Quezka/moneysort/docs/GRIPPER.md

# Gripper research: suction cup for coins

> The build that follows from this research is in [`PUMP.md`](PUMP.md).

Notes from a web search (2026-10-14) on how to pick up coins. Nothing here is
built yet; this records the options and the decision so far.

## Decision (so far)

A **small DC diaphragm vacuum pump + a solenoid release valve**, both switched by
logic-level MOSFETs from two Pi GPIOs. Not a venturi ejector: it needs
compressed air (a compressor and regulator), which is out of scale for a desk arm.

## How much suction a coin needs (our estimate, not from a source)

A coin weighs 2-9 g. A 5 mm cup at -30 kPa holds about 60 g (F = P x A), so the
margin is 5x or more. Coins are flat and seal well: the cup (small, soft lip or
bellows) matters more than pump flow.

Reference: the uArm Swift's built-in pump uses 5-10 mm cups, reaches 33 kPa and
lifts 1 kg ([datasheet](https://www.mouser.com/datasheet/2/813/uArm-Swift-Specifications-en-1223866.pdf)).

## Venturi ejectors (rejected)

- [Anver JV miniature venturi](https://anver.com/venturi%20vacuum%20pumps.htm): 16 g, no moving parts, up to 26" Hg,
  millisecond attach and release. Needs compressed air; air use is the main cost.
- [Riegler SCP 101-M mini-pump](https://riegler.de/de/en/mini-compact-ejector-mini-pump-nozzle-size-1-mm-nc-108397-1.html):
  built-in vacuum switch, 85% evacuation, about 639 EUR ex VAT. Out of proportion.

## Pumps found

- [SparkFun 12 V diaphragm pump (ROB-10398)](https://sparkfun.com/products/10398): 1000 h rated life. Works, but bigger than needed.
- [Evelta 12 V brushless piston pump](https://evelta.com/12v-mini-brushless-piston-vacuum-pump-for-suction-systems-max-flow-26l-min/)
  (18 or 26 L/min): made for pick-and-place, oversized for coins.
- Better: a micro diaphragm pump of the kind built into small arms. No specific
  buyable model found yet (open item).

## Release valve is required

Switching the pump off does not release the grip
([SparkFun community thread](https://community.sparkfun.com/t/an-open-source-robot-arm-project/27897/13)).
Put a solenoid valve on the line that vents the cup to atmosphere. So two outputs:
pump and valve. A normally-open valve vents on power loss (a coin drops rather
than stays held on a dead arm).

## Driving it from the Pi

- GPIO is 3.3 V only: switch the pump and valve through **logic-level MOSFETs**
  (gate threshold below ~2.5 V) with a flyback diode across each load, GND common
  with the Pi. Avoid IRF520 modules: they need ~10 V on the gate.
- Choosing a **24 V** pump and valve lets them share the stepper PSU (no converter).
  A 12 V part needs a 24 -> 12 V buck.

The cycle that will call the pump (`pick()` / `release()` hooks, drop spot, calibration) is in
[`PICKING.md`](PICKING.md).

## Open items

- Pick a concrete pump + valve + cup (5-8 mm, soft lip or bellows) available in Italy.
- Choose two free GPIO pins (check `PINOUT.md`).
- Software: pins in `config.py`, a `Gripper` in `hardware/`, `POST /grip` with a
  dead-man like `/jog` (never leave the pump running on a lost connection).

## Where to buy (searched 2026-10-14; check price, stock and real specs before ordering)

Cups (Italy, RS Components): [SMC ZP06BS](https://it.rs-online.com/web/p/ventose-pneumatiche/2273884) 6 mm bellows
(6.80 EUR + VAT), [SMC ZP2-05ZJS](https://it.rs-online.com/web/p/ventose-pneumatiche/0391989) 5 mm bellows (7.02 EUR + VAT).
Those are the pad only: check the mounting/fitting (nipple or holder) before buying. Cheap alternative: uxcell 6 mm
with M5 joint, 4 pcs ([Amazon listing](https://www.amazon.com/clp/B07MG5PK77)).

Pump + valve kits (6 V class, the "Arduino robot arm" kind):
- AliExpress: [pump + valve + PWM switch + cup](https://www.aliexpress.com/item/4000186490327.html),
  [same kit, other seller](https://aliexpress.com/item/1005003181120488.html),
  [cup + pump for Arduino arms](https://www.aliexpress.com/item/1005002310813942.html). Listing text is marketing:
  confirm the pump voltage (5-6 V) and vacuum (kPa) with the seller.
- Little Bird (AU) and ThinkRobotics sell the same kind of kit (pump 4.5-6.6 V, 3-way valve 6 V).
- DFRobot 6 V 3-way air valve ([RobotShop EU](https://eu.robotshop.com/products/dfrobot-6v-2-position-3-way-air-valve-arduino), ~100 mA, 40 kPa max).
- Alibaba is wholesale: [6 V mini vacuum pumps](https://pumpdyx.en.alibaba.com/productgrouplist-214713373/Mini_Vacuum_Pump.html),
  [vacuum release valves](https://www.alibaba.com/showroom/micro-vacuum-valve.html); expect minimum orders and no datasheets.
- Amazon.it: nothing suitable found by search (only 220 V HVAC pumps). Search on the site for "pompa vuoto 6V DC mini".

What to look for: pump 5-6 V DC, vacuum at least -40 kPa, a 3-way valve (so the cup vents on release), 4-5 mm nozzle.
A 6 V part needs its own supply (24 V -> 6 V buck), not the Pi's 5 V rail.

## Pump candidate (screenshot kept)

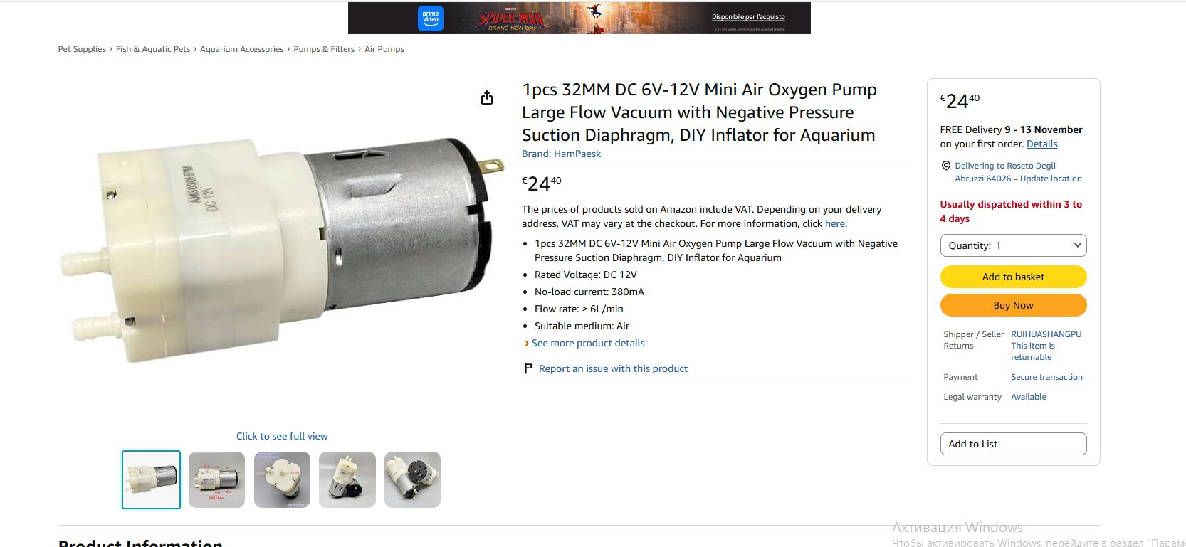
[picture p1: docs/img/pump-candidate-amazon-hampaesk.png]
Amazon.it listing, HamPaesk 32 mm pump


Amazon.it, 2026-10-14: "32MM DC 6V-12V Mini Air Oxygen Pump, Large Flow Vacuum with Negative Pressure Suction
Diaphragm" (brand HamPaesk, ASIN B0FNN55NGD), 24.40 EUR incl. VAT, returnable. Listed: rated 12 V (title says 6-12 V),
no-load 380 mA, flow > 6 L/min, medium air, two barbed ports. **Max vacuum is not stated** (the number that matters
for coins: want at least -50 kPa); price is high for this pump class. Ask the seller / read "more product details"
before buying; a 12 V part needs a 24 -> 12 V buck and a 12 V 3-way valve.
