Quezka/moneysort/docs/CAMERA_MOUNT.md

# Camera mount: RealSense D435 on the front of the arm

3D model (parametric, printable) of a bracket that carries the D435 at the **front of the arm**, plus a
holder for the suction nozzle. Source: [`cad/camera_mount.py`](../cad/camera_mount.py); print file:
[`cad/camera_mount.stl`](../cad/camera_mount.stl); assembly with a plate stub and a camera mock-up:
[`cad/camera_mount_assembly.stl`](../cad/camera_mount_assembly.stl) (for a viewer, not for printing).

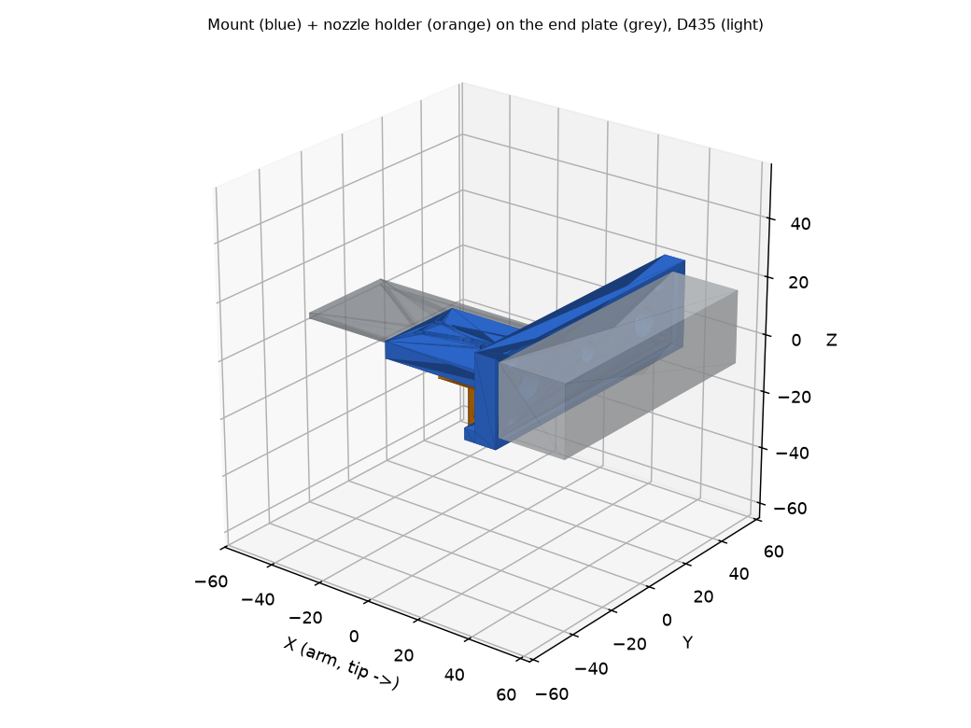
[picture p2: docs/img/camera-mount-iso.png]
Mount on the end plate


## What the photos show

- The forearm ends in a **horizontal flat plate** (the levelling wrist keeps it level at every pose), carried
  by a triangular gusset and two vertical side plates, with brass hex standoffs behind it.
- The plate has a **rectangular window ~40 x 20 mm** with **4 small holes** (two at each end of the window):
  the pattern of a standard servo bracket (MG996R: 49.5 x 10 mm). The window is on the arm's axis, with the long
  side along the arm. The plate's front edge is ~32 mm in front of the window centre, and about 36 mm wide.
- The D435 is 90 x 25 x 25 mm with a **1/4-20 tripod thread in the middle of its bottom face** and a USB-C
  connector on one short end.
- The brass standoffs sit ~10 mm above the plate: there is room for bolt heads on top of the plate.

These dimensions come from the photos (scale taken from the 20 x 40 mm window), so they are good to a
millimetre or two, not better: see **Check before printing**.

## The design

```
          side view (arm to the left, tip to the right)

  ======== plate (2) =========[ window ]===========+
          | printed block (6) under the plate      |#| wall (8) in front of the plate edge
          +----------+---------+------------------+#|----[ D435 ]----   <- lens face looks DOWN
                     | boss (nozzle holder)         |
                     | tube / cup stem
```

- **Block** (34 x 61 x 6 mm) under the plate, bolted through the 4 plate holes (M3 bolts from the top, nuts in
  hexagonal pockets on the underside). The pull of the camera's weight is resisted by the holes 49.5 mm apart.
- **Wall** (98 x 8 mm) right in front of the plate edge. The camera's **bottom face** is bolted to it with the
  1/4-20 screw, turned so that its **lenses look straight down** (the plate is always level, so the camera
  always looks straight down). A shallow pocket (90.6 x 25.6 x 2 mm) stops it rotating. The camera ends up with
  its long axis across the arm and the lens face 4 mm below the plate.
- **Nozzle holder** (a separate small part, `cad/nozzle_holder.stl`, printed flange-down): a 14 mm tube with a 6.4 mm
  bore hanging under the block, exactly under the plate window (the window is the opening for the tube going up to the
  pump), with an M3 set screw to clamp the stem. Two M3 bolts go in from the top through the window and the block, nuts in
  the flange. Adapt the bore when the suction cup is chosen ([`GRIPPER.md`](GRIPPER.md)).
- Four cable-tie slots (both wings, so the USB-C end can face either side) and lightening holes in the wings.
- Printed parts: mount 30 cm^3 (about **21 g** with 40% infill, PETG) + holder 4 g. Total added load about 110 g (camera 72 g, bolts).

### Why the camera is *in front of* the nozzle

- The **nozzle sits ~51 mm behind the camera centre**, 47 mm lower than the lens face. Seen from the lens the
  nozzle is 47 deg off the vertical (the depth stream sees +-29 deg along the arm), so it is **never in the
  picture** and does not occlude coins. The picture still contains the spot under the nozzle (about 106 px
  behind the image centre at 30 cm height): `--calibra` learns that pixel.
- The camera stays **above the pile**: while the nozzle touches a coin the lens is ~50 mm above the table.
- The window region of the plate is used by the nozzle, so there is nowhere else to put the camera (behind the
  window are the standoffs and side plates).
- Rejected: camera on top of the arm tilted forward (the image would no longer be straight down, which the pixel
  model likes); camera behind the nozzle (hangs in the middle of the structure); a long mast (moment on the
  shoulder, which already stalls at full extension).

## Check before printing (calipers, 2 minutes)

All of these are variables at the top of `cad/camera_mount.py`; change them and run `python cad/camera_mount.py`.

| Measure | Value used | Note |
|---|---|---|
| Hole pattern, along the arm (`HOLES_DX`) and across (`HOLES_DY`) | 49.5 x 10 | the photo says 47-49.5 along |
| Hole diameter (`BOLT`) | M3 | the holes look **2.6-3 mm**: if they are 2.6 use M2.5 (`BOLT = 2.5`) or drill them to 3.2 |
| Plate thickness (`PLATE_T`) | 2.0 | only used for the previews |
| Plate front edge from the window centre (`PLATE_EDGE_X`) | 32 | decides where the wall stands: it must be *just in front* of the edge |
| Plate width (`PLATE_HALF_W`) | 18 | the block is 34 wide; it must stay inside the plate |
| Window (`WINDOW`) | 40.6 x 20.2 | the bore must stay under it |
| D435 | 90 x 25 x 25, thread 1/4-20 | check the thread depth (about 6-7 mm): the screw is 3.5 mm of wall + 6 mm of thread |
| Space above the plate behind the wall | | the screw head (12 mm) sits there, it needs a hand/driver |

## Bill of materials

### Screws and nuts (the shopping list)

| Where | What | Qty |
|---|---|-----|
| Block to the end plate (through the 4 plate holes, from the **top**) | **M3 x 8 mm** bolt (cap or button head; 10 mm at most) | 4 |
| ... their nuts, in the hexagonal pockets under the block | **M3 hex nut** (5.5 mm across flats, 2.4 mm thick) | 4 |
| Nozzle holder to the block (from the top, through the plate window) | **M3 x 12 mm** bolt | 2 |
| ... their nuts, in the holder's flange | **M3 hex nut** | 2 |
| Nozzle clamp (set screw across the holder tube) | **M3 x 8 mm grub screw** (headless, hex socket) | 1 |
| ... its nut, in the pocket on the tube | **M3 hex nut** | 1 |
| Camera to the wall (the camera's own tripod thread) | **1/4"-20 UNC x 3/8" (9.5 mm) socket-head cap screw** | 1 |
| Cable | cable ties, 2.5 mm wide | 4 |

Totals to buy: **M3 x 8 bolts: 4, M3 x 12 bolts: 2, M3 x 8 grub screw: 1, M3 nuts: 7, 1/4"-20 x 3/8" screw: 1** (buy a few
spares of each). Hex keys: 2.5 mm (M3 cap screw; 2 mm for button heads), 1.5 mm (M3 grub screw), 3/16" (1/4" screw).
Nylon-insert (nyloc) nuts do not fit the pockets: use plain M3 nuts, with a drop of thread-lock if they work loose.
The 1/4" screw is sold as a "camera screw" / "tripod screw"; take the **socket-head** kind, a knurled thumbscrew does
not fit in the recess.

### Printed parts and other

- 2 printed parts: `camera_mount.stl` (as modelled: underside on the bed, wall standing up, **no supports**) and `nozzle_holder.stl`
  (flange on the bed, tube up). Holes print ~0.2 mm small: the 6.4 mm nozzle bore and the 6.7 mm tripod hole may need a
  drill (6.4 / 6.7 mm) to finish.
- A short, good **USB 3 cable** (a bad one drops the D435 to USB2: 6 fps, noisy depth).

## First print: PLA to try, PETG for the real one

Print the **first copy in PLA**: cheap, easy, and it tells you at once whether the measurements are right.
Use it to check:

- the 4 block holes line up with the plate holes, and the wall stands just in front of the plate edge;
- the camera fits the pocket and the 1/4" screw bites its thread (see the screw note below);
- the M3 nuts fit their pockets, and a hand and a hex key reach the screw head behind the wall;
- the USB cable has room.

Things to know about PLA:

- It is fine for trying and for the first motion tests (21 g part, ~110 g total load).
- It **softens above ~50-55 degC and creeps under constant load**: a warm room or sun can bend it slowly and the camera would
  drift without you noticing. Once the fit is confirmed, print the final one in **PETG or ABS**.
- It is stiffer but more brittle than PETG: do not over-tighten, especially the 1/4" screw (it usually cracks at that hole).
  Use 5 perimeters, 40% infill, 0.2 mm layers.
- **Do the final `center_coin.py --calibra` on the final part**, not on the PLA one: another material or a re-print can shift the camera
  by a few tenths of a millimetre.

If the test fit shows something wrong (a hole off by a millimetre, the cable in the way), change the variable at the top of
`cad/camera_mount.py` and run it again before printing the final one.

### The 1/4" screw length

The wall under the camera is 3.5 mm thick, so a 3/8" (9.5 mm) screw grips the camera's thread for 6 mm. Check your camera first:
screw the bolt into the bare camera by hand until it stops; the usable length is that depth minus 1 mm. If it stops sooner, use a shorter
screw.

## Assembly

1. Slide the 4 nuts into the pockets on the underside of the block.
2. Hold the block under the plate, wall in front of the edge, and put the 4 bolts through the plate from the top.
3. Put the 1/4-20 screw through the wall (head recess on the rear side) into the camera's bottom thread, lens down. Tighten gently by hand: it is a plastic wall.
4. Run the USB cable along the arm with the ties.
5. **Redo the calibrations** (below).

## What changes in the software

- The image is now landscape with its long side across the arm. `center_coin.py` relearns the pixel Jacobian
  by itself on every run, so nothing to change.
- **Redo `python3 tools/center_coin.py --calibra`** (and delete the old `camera_calib.json` / `nozzle_calib.json`):
  the camera moved relative to the tool. It learns the nozzle pixel and the **touch height**, which will be about
  +50 mm (the nozzle hangs ~51 mm below the plate underside; the exact value depends on where the old tool point was).
- **Reach improves a lot.** Until now the tool point had to go down to the coin surface (Z about -10), reachable only
  between 29 and 37 cm from the base. With the nozzle hanging 51 mm below the plate, the plate only has to reach
  Z about +45, reachable up to about 43 cm (see the table in [`PICKING.md`](PICKING.md)).
- The kinematic model (`domain/kinematics.py`, `D` = vertical offset, `TOOL_REACH_MM`) describes the old tool point:
  for exact `move_to` of the nozzle, lower `D` by the nozzle length and shift `TOOL_REACH_MM` by its X offset, or just
  rely on the learned touch height (what `center_coin.py` does).
- Added load about 110 g, 0.35-0.5 m from the shoulder, which already stalls at full extension: keep the part light, and
  if the shoulder complains lower `SHOULDER_MAX_DEG`.

## Open points

- The nozzle bore, boss and set screw are a placeholder until the suction cup and its stem are chosen.
- If the plate holes are not usable, a clamp version (two printed halves gripping the plate edges) is a small change.
- A 10-15 degree forward tilt would show more of the table ahead of the arm; not worth losing the straight-down view yet.
