Quezka/moneysort/docs/img/camera-mount-part.png

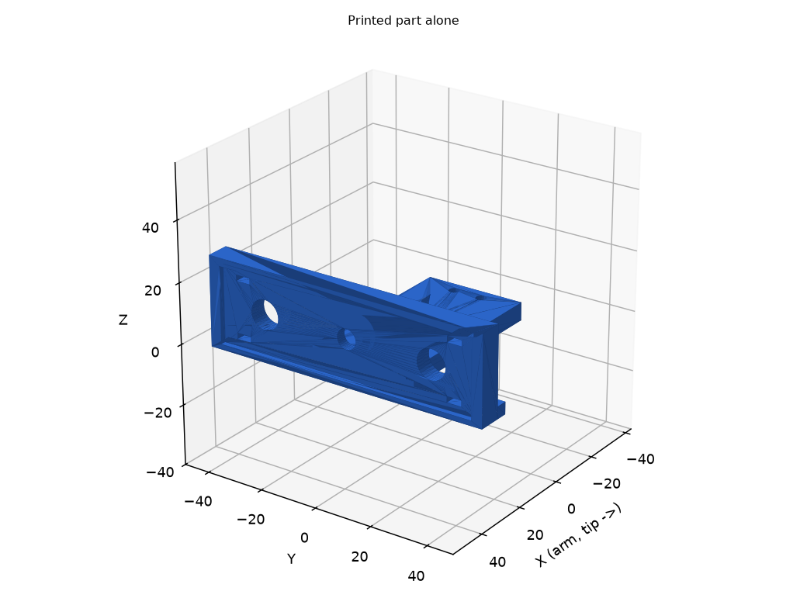
docs/img/camera-mount-part.png
