Quezka/moneysort/docs/img/camera-mount-side.png

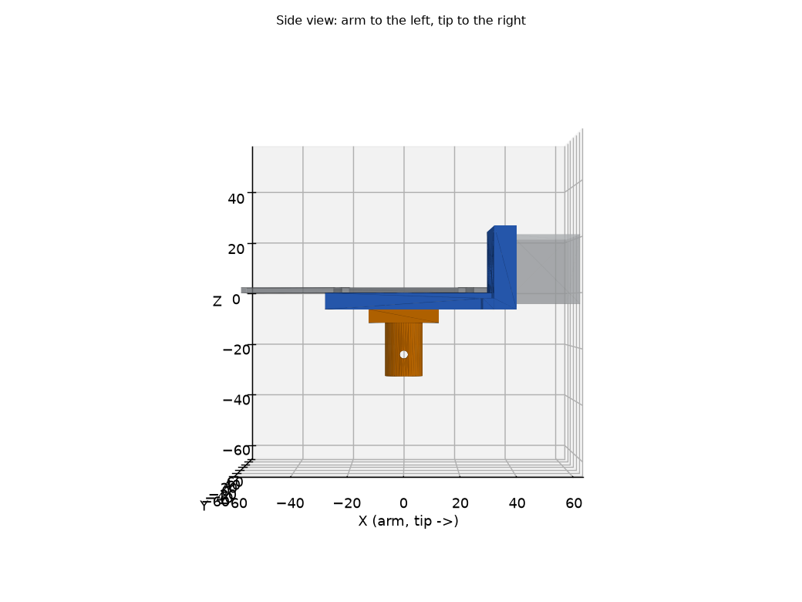
docs/img/camera-mount-side.png
