Quezka/moneysort/docs/img/camera-mount-top.png

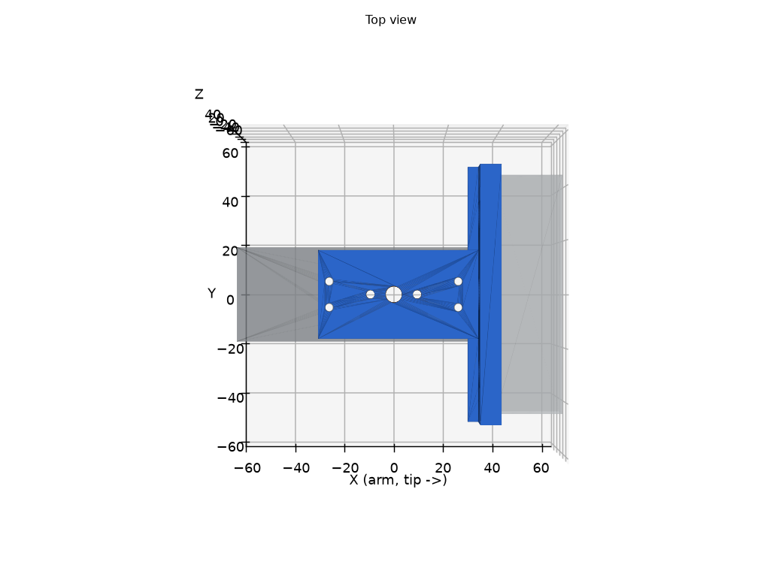
docs/img/camera-mount-top.png
