Quezka/moneysort/imgs/braccio_diagonale.jpg

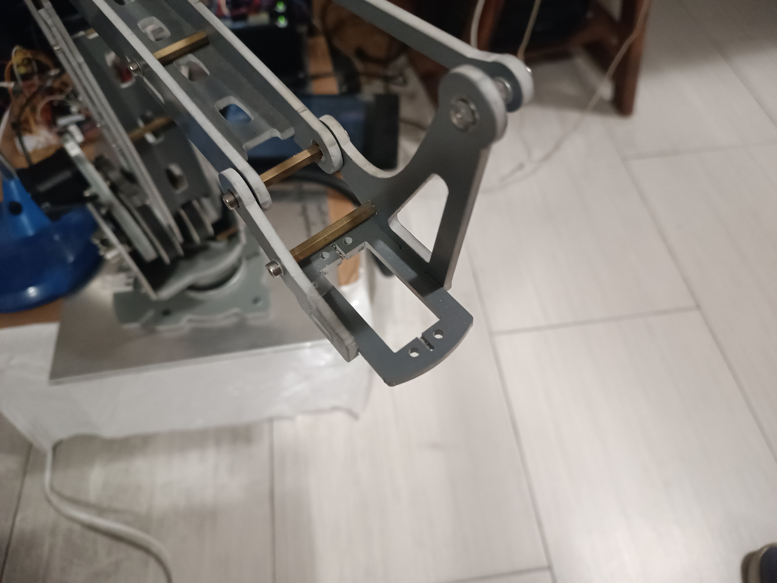
imgs/braccio_diagonale.jpg
