Quezka/moneysort/imgs/braccio_fronte.jpg

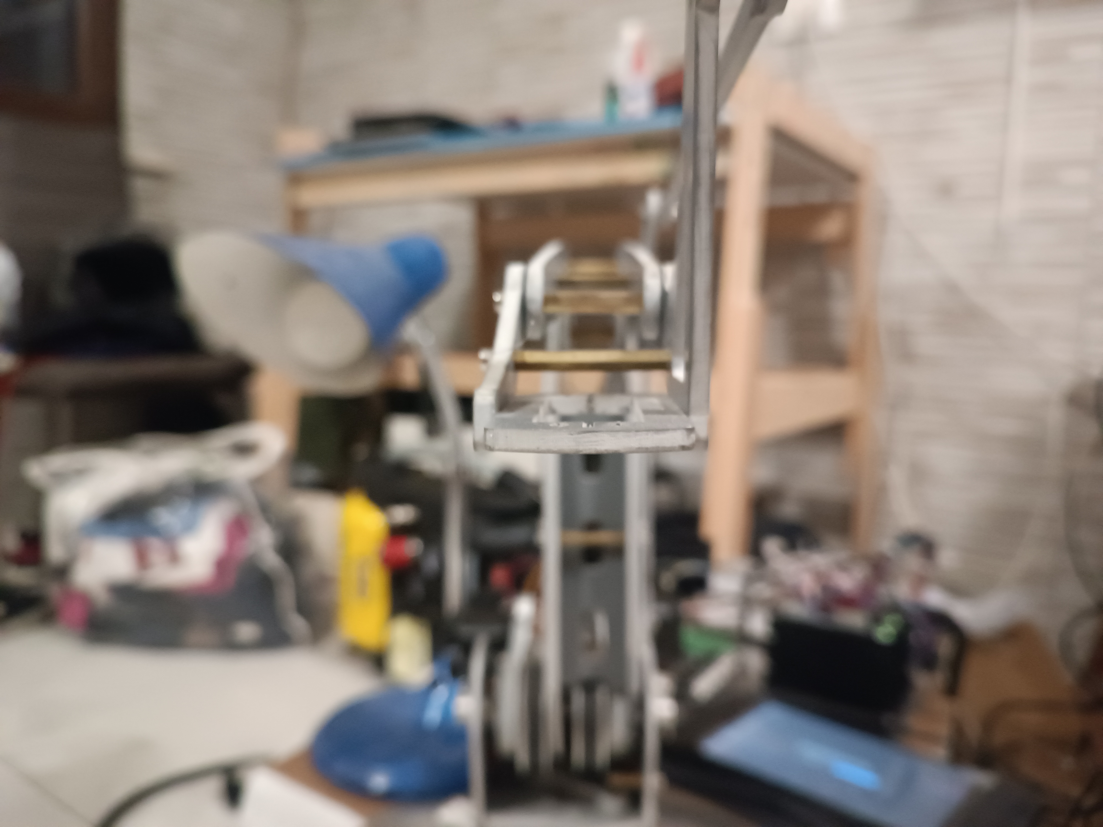
imgs/braccio_fronte.jpg
