Quezka/moneysort/imgs/braccio_lato.jpg

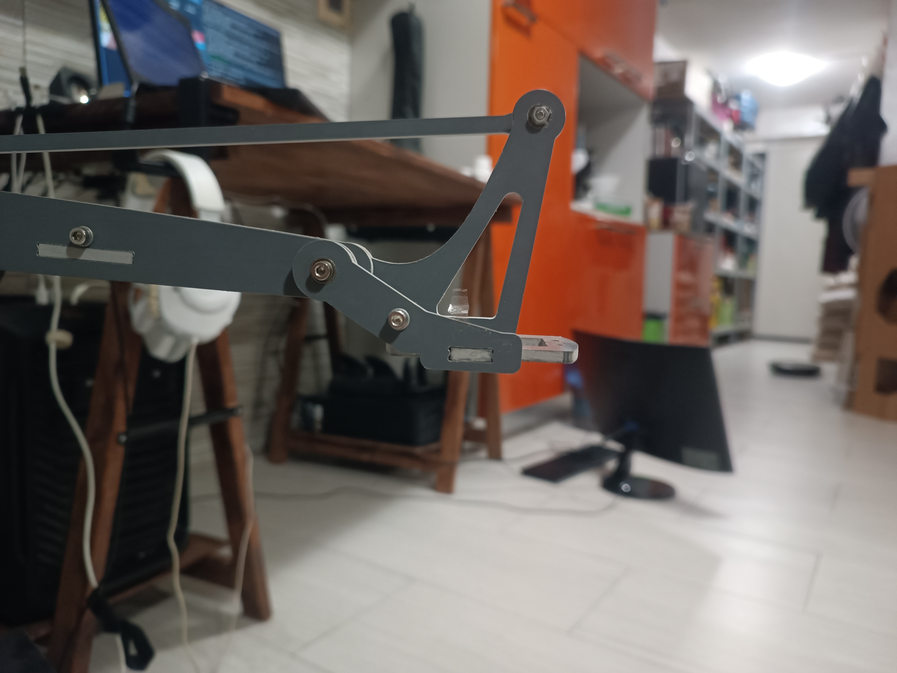
imgs/braccio_lato.jpg
