Quezka/moneysort/imgs/braccio_sopra.jpg

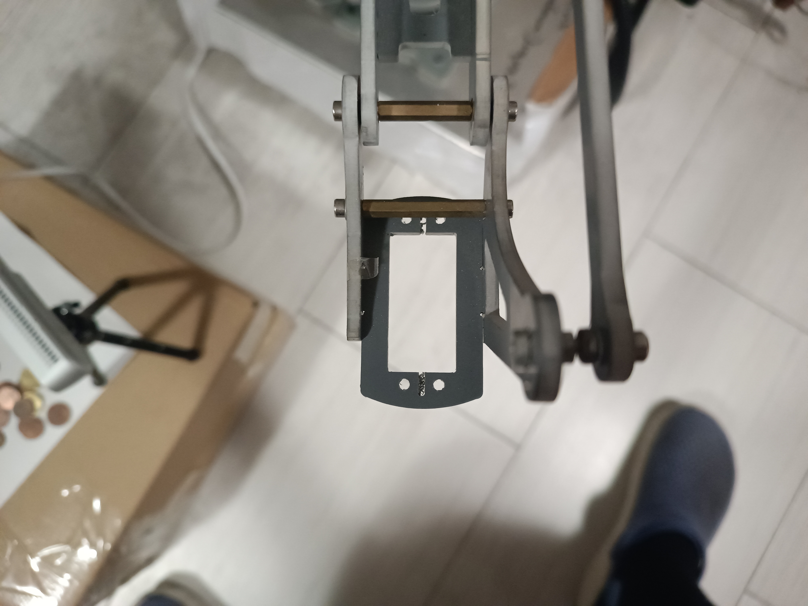
imgs/braccio_sopra.jpg
