Quezka/moneysort/imgs/camera_diagonale_f.jpg

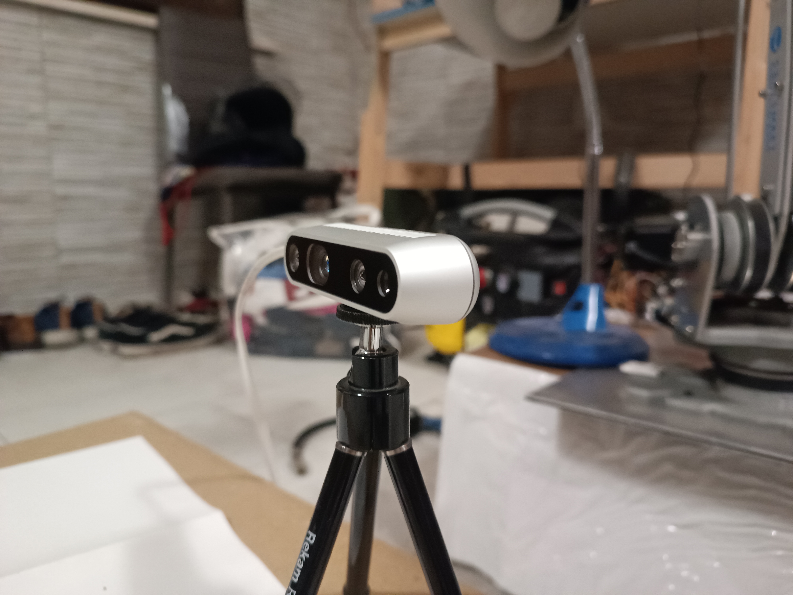
imgs/camera_diagonale_f.jpg
