Quezka/moneysort/imgs/camera_diagonale_r.jpg

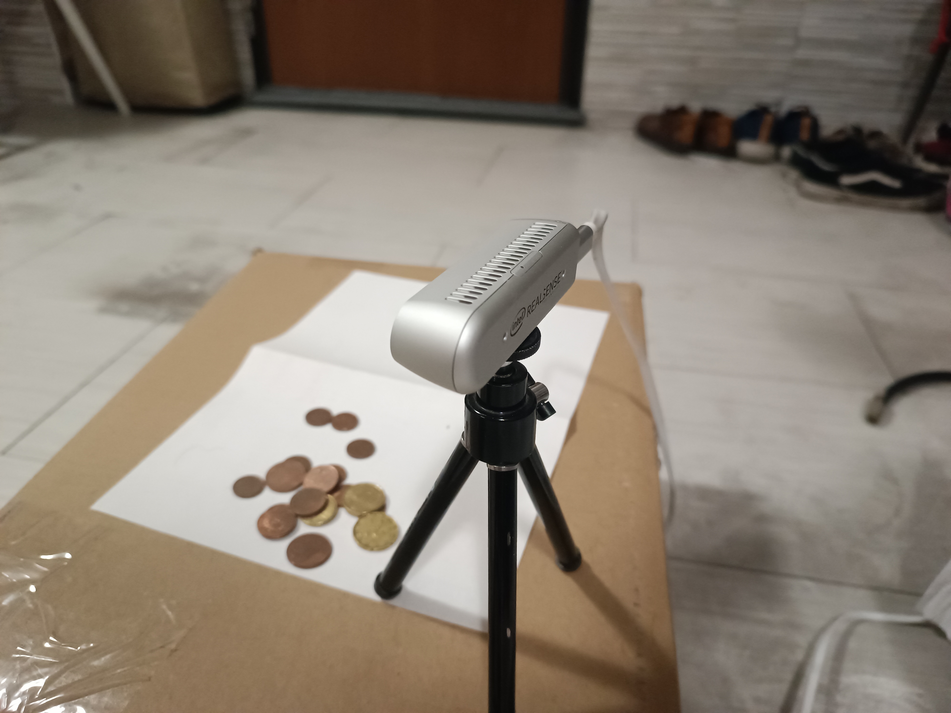
imgs/camera_diagonale_r.jpg
