Quezka/moneysort/cad/pickup_nozzle_assembly.stl

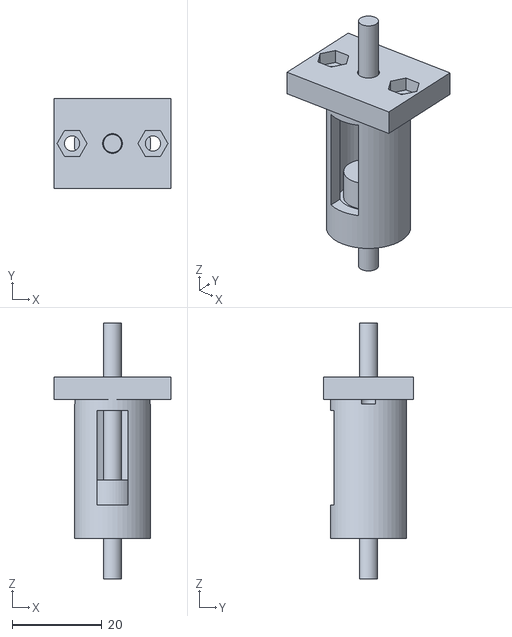
[picture p12: CAD file, 2026-10-26]
cad/pickup_nozzle_assembly.stl
26.0 x 20.0 x 57.0
