Quezka/moneysort/cad/camera_mount_assembly.stl

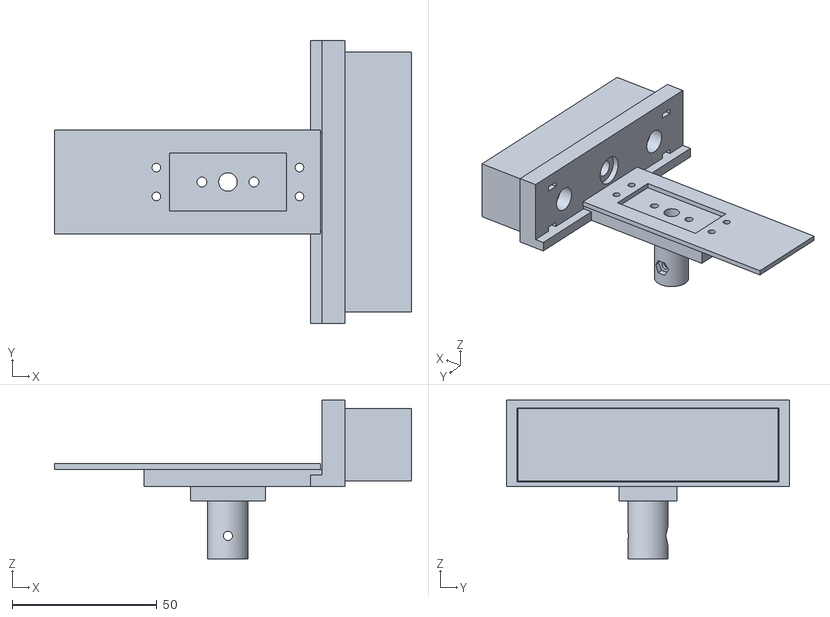
[picture p13: CAD file, 2026-10-16]
cad/camera_mount_assembly.stl
123.5 x 98.0 x 55.0
