Quezka/moneysort/cad/pickup_housing.stl

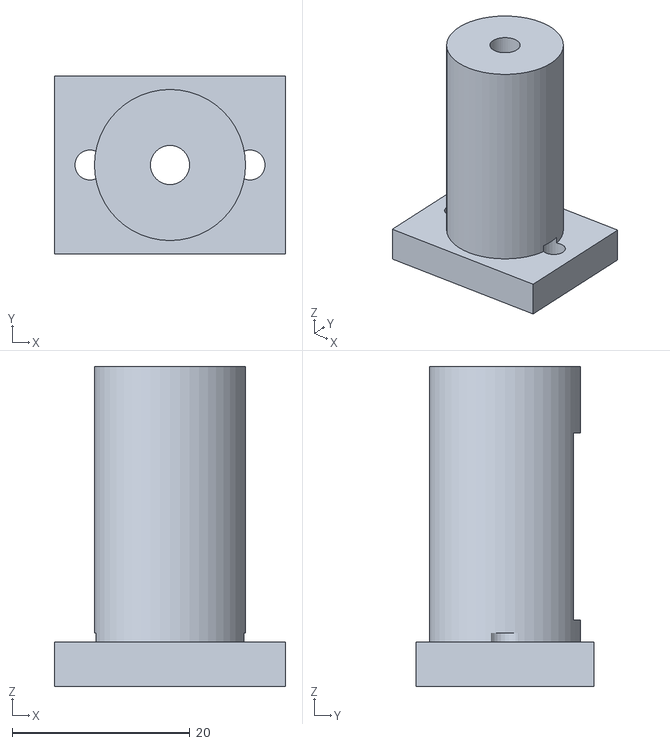
[picture p14: CAD file, 2026-10-26]
cad/pickup_housing.stl
26.0 x 20.0 x 36.0
