Quezka/moneysort/cad/pickup_collar.stl

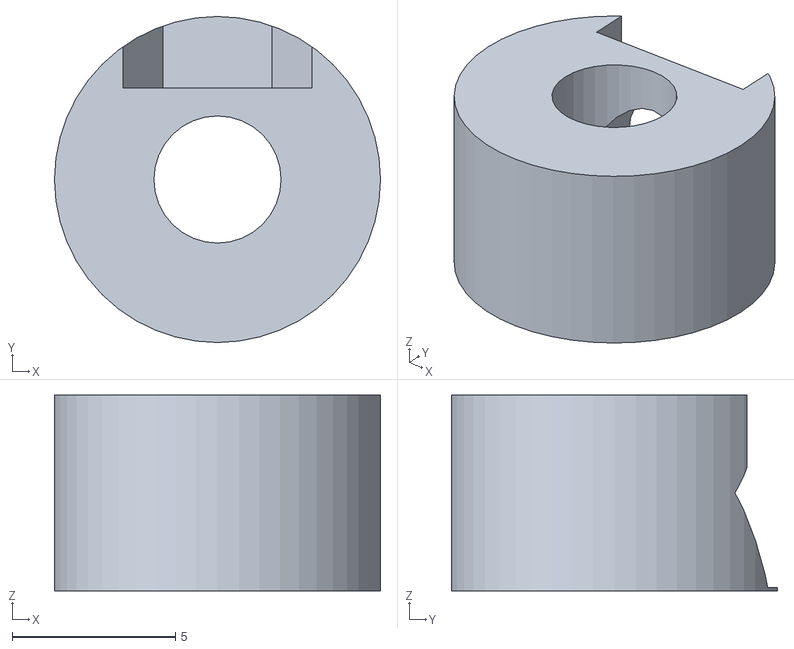
[picture p15: CAD file, 2026-10-26]
cad/pickup_collar.stl
10.0 x 10.0 x 6.00
