Quezka/moneysort/cad/nozzle_holder.stl

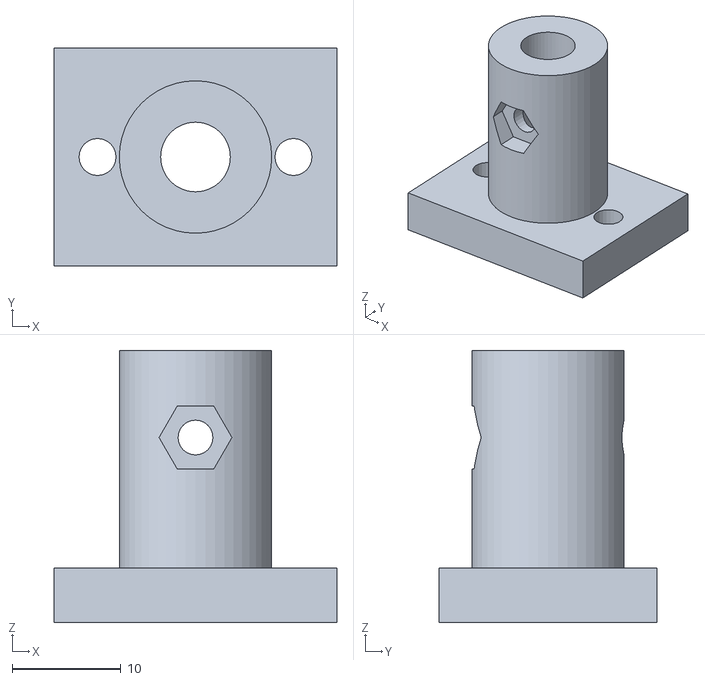
[picture p16: CAD file, 2026-10-16]
cad/nozzle_holder.stl
26.0 x 20.0 x 25.0
