Quezka/moneysort/cad/camera_mount.stl

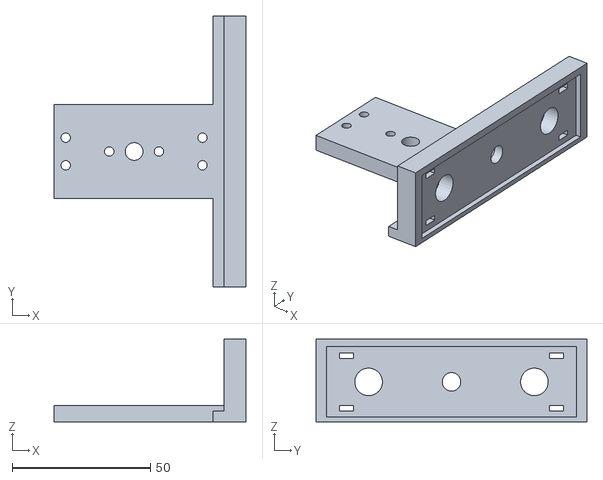
[picture p17: CAD file, 2026-10-16]
cad/camera_mount.stl
69.5 x 98.0 x 30.0
