Quezka/moneysort/moneysort/app/arm.py

#!/usr/bin/env python3
"""Multi-axis arm built from Stepper joints sharing one gpiochip handle.

Pins and calibration live in `moneysort.config.JOINTS` (see docs/PINOUT.md):
    x = elbow (home switch GPIO7)   y = shoulder (home switch GPIO8)
    z = base (continuous, no switch)
Shared enable on GPIO26 (active-low). All '-' terminals bus to Pi GND.
If a joint runs the wrong way, set "invert": True for it in JOINTS.
"""
import logging
import threading
import time

import lgpio

from moneysort.config import ANCHOR_PIN, ENABLE_PIN, GPIOCHIP, JOINTS, RETURN_ZERO_PPS
from moneysort.domain import kinematics
from moneysort.hardware.stepper import ANCHOR, ROOM_TIMEOUT_S, TX_LOCK, Stepper


log = logging.getLogger("armd.arm")

FINE_SLACK_STEPS = 1500   # extra slow-approach steps allowed beyond the back-off before giving up


class Arm:
    def __init__(self, joints=JOINTS, enable_pin=ENABLE_PIN, **stepper_kwargs):
        self.h = lgpio.gpiochip_open(GPIOCHIP)
        self.enable_pin = enable_pin
        # Claim LOW so all drivers come up enabled/holding.
        lgpio.gpio_claim_output(self.h, enable_pin, 0)
        self._enabled = True
        self.cfg = joints                       # per-axis config (limits, homed, ...)
        # Shared e-stop flag: disable() sets it so any in-flight move on any axis
        # bails out at once; enable() clears it. Handed to every Stepper.
        self.abort = threading.Event()
        self.motors = {}
        for name, c in joints.items():
            kw = dict(stepper_kwargs)
            if "steps_per_rev" in c:
                kw["steps_per_rev"] = c["steps_per_rev"]
                kw.setdefault("microsteps", 1)
            self.motors[name] = Stepper(
                self.h, c["step"], c["dir"],
                invert_dir=c.get("invert", False), abort=self.abort, **kw)
        if ANCHOR_PIN is not None:                  # silent head record that keeps lgpio's tx thread from wedging
            ANCHOR.setup(self.h, ANCHOR_PIN, self.motors.values())
        # Claim home-switch pins as pull-up inputs (NC to GND).
        self.home_pins = {}
        for name, c in joints.items():
            if "home_pin" in c:
                lgpio.gpio_claim_input(self.h, c["home_pin"], lgpio.SET_PULL_UP)
                self.home_pins[name] = c["home_pin"]
        # Travel limits, in steps. Two kinds:
        #  - switch-homed axes (x, y): one-sided from the switch (position 0),
        #    extending opposite the home direction; enforced only once homed.
        #  - switch-less axes (z): a symmetric hard limit +/-limit_deg around the
        #    power-on / zeroed position; always enforced (there's no switch to
        #    home against, so its zero reference is the only one it has).
        self._limits = {}
        for name, c in joints.items():
            t = c.get("travel")
            if t:
                self._limits[name] = (0, t) if c.get("home_dir", -1) < 0 else (-t, 0)
            elif c.get("limit_deg"):
                span = round(c["limit_deg"] / 360.0 * c["steps_per_rev"])
                self._limits[name] = (-span, span)
        self.homed = set()

    # --- shared enable ----------------------------------------------------
    def enable(self):
        """Energize all drivers (motors hold). Always works: no opto current."""
        self.abort.clear()                       # lift the e-stop latch on motion
        lgpio.gpio_write(self.h, self.enable_pin, 0)
        self._enabled = True

    def disable(self):
        """Release all drivers (motors go free) and abort any motion in flight.

        Setting `abort` makes every running move/home loop stop feeding pulses
        and cut its train short, so an emergency disable stops the *task*, not
        just the torque. Positions are now unknown after an abrupt stop, so all
        axes are marked un-homed -- soft limits stay off until you re-home.
        """
        self.abort.set()
        lgpio.gpio_write(self.h, self.enable_pin, 1)
        self._enabled = False
        self.homed.clear()
        for name, m in self.motors.items():       # end any running (even infinite) pulse train
            if m.busy() and not m.cancel():           # e-stop = hard stop, not "queue one more cycle"
                log.error("e-stop: axis %s pulse train could not be stopped", name)

    @property
    def enabled(self):
        return self._enabled

    def __getitem__(self, name):
        return self.motors[name]

    def _clamp_steps(self, name, steps, quiet=False):
        """Trim `steps` so a travel-limited axis can't overtravel.

        A switch-homed axis (x, y) enforces its limit only once homed -- before
        that its position isn't tied to a real reference. A switch-less axis (z)
        has no switch, so its limit is a hard bound around its zero reference and
        is always on.
        """
        lim = self._limits.get(name)
        if lim is None:
            return steps
        if name in self.home_pins and name not in self.homed:
            return steps
        lo, hi = lim
        pos = self.motors[name].position
        target = pos + steps
        if pos > hi:                       # already outside (limit tightened / stalled):
            target = min(target, pos)      # only inward moves, never snap back in one lurch
        elif pos < lo:
            target = max(target, pos)
        else:
            target = max(lo, min(hi, target))
        if target - pos != steps and not quiet:
            log.warning("limit: axis %s asked %+d steps at %d (limits %d..%d) -> allowed %+d",
                        name, steps, pos, lo, hi, target - pos)
        return target - pos

    def move(self, name, steps, max_pps=None):
        steps = self._clamp_steps(name, int(steps))
        self.motors[name].move(steps, max_pps=max_pps)

    def jog_slice(self, steps, dt):
        """Queue one jog slice per axis ({axis: signed steps}) to play over `dt` s.

        Soft limits apply (same clamp as move). Returns the steps actually queued,
        so the caller can see an axis that hit its limit."""
        done = {}
        for name, n in steps.items():
            n = self._clamp_steps(name, int(n), quiet=True)     # 25 Hz: the loop logs transitions
            done[name] = n
            self.motors[name].queue_slice(n, dt)
        return done

    def move_degrees(self, name, degrees, max_pps=None):
        m = self.motors[name]
        self.move(name, round(degrees / 360.0 * m.eff_spr), max_pps=max_pps)

    def move_to(self, point, max_pps=None):
        """Move the tool tip to a Point (mm, base frame) via inverse kinematics.

        Solves the joint angles, converts each to an absolute step target, and
        drives all axes together with move_many. Requires x and y to be homed
        (their positions must map to real angles for FK/IK to be meaningful);
        raises kinematics.OutOfReach if the point is unreachable.
        """
        needs = {"x", "y"} & set(self.motors)
        if not needs.issubset(self.homed):
            missing = sorted(needs - self.homed)
            raise RuntimeError(f"home {missing} before move_to (need a position reference)")
        angles = kinematics.inverse(point)                 # raises OutOfReach
        moves = {}
        for name, deg in (("x", angles.x), ("y", angles.y), ("z", angles.z)):
            m = self.motors.get(name)
            if m is None:
                continue
            target = round(deg / 360.0 * m.eff_spr)        # absolute step position
            moves[name] = target - m.position              # relative move
        self.move_many(moves, max_pps=max_pps)

    def home_all(self, max_pps=None):
        """Home the whole arm in one call, one axis at a time.

        Axes with a home switch (x, y) seek it via find_home and re-zero on it;
        switch-less axes (z/base) just drive back to their existing zero (no-op
        if already there). Stops early if the e-stop abort fires.
        """
        for name, m in self.motors.items():
            if self.abort.is_set():
                break
            if name in self.home_pins:
                self.find_home(name)
            else:
                m.go_home(max_pps=max_pps)

    def return_zero(self, max_pps=None):
        """Drive every axis back to its zero position, one at a time.

        Unlike home_all this seeks no switch -- it just undoes the tracked net
        motion (a no-op for an axis already at 0), so it relies on the current
        position being trusted (homed or freshly zeroed). This is the everyday
        "go home" move; switch homing is the occasional re-init. Runs at
        RETURN_ZERO_PPS unless a speed is given (gentle: it may start fully extended).
        """
        max_pps = max_pps or RETURN_ZERO_PPS
        for m in self.motors.values():
            if self.abort.is_set():
                break
            m.go_home(max_pps=max_pps)

    def move_many(self, moves, max_pps=None):
        """Move several axes at once. moves = {axis: steps}.

        Each STEP pin has its own lgpio tx queue that plays independently, so we
        set every axis's direction, then interleave-feed their trapezoid bursts
        (round-robin as each queue frees room) -- all axes ramp and run together.
        """
        plans = {}
        for name, steps in moves.items():
            steps = self._clamp_steps(name, int(steps))
            if steps == 0:
                continue
            m = self.motors[name]
            level, segs = m.plan(steps, max_pps)
            m.set_dir(level)
            plans[name] = [m, list(segs), steps]
        if not plans:
            return
        time.sleep(0.001)                      # DIR setup for all axes

        pending = {name: p[1] for name, p in plans.items()}
        last_progress = time.monotonic()
        while pending and not self.abort.is_set():
            progressed = False
            for name in list(pending):
                segs = pending[name]
                if plans[name][0].try_queue(*segs[0]):
                    segs.pop(0)
                    progressed = True
                    if not segs:
                        del pending[name]
            if not progressed:
                if time.monotonic() - last_progress > ROOM_TIMEOUT_S:
                    for n in pending:                       # free the wedged queues before failing
                        self.motors[n].cancel()
                    raise RuntimeError("TX queues stuck: no room for %ss (%s)" % (
                        ROOM_TIMEOUT_S, ", ".join(sorted(pending))))
                time.sleep(0.001)          # all queues full; let them drain
            else:
                last_progress = time.monotonic()
        for m, _, _ in plans.values():     # drain every queue (bursts are
            m.drain()                      # short, so an abort clears fast)
        if not self.abort.is_set():        # positions unknown after an abort
            for m, _, steps in plans.values():
                m.position += steps

    def zero(self, axis=None):
        """Define the current position as 0 (manual home). One axis or all."""
        motors = [self.motors[axis]] if axis else self.motors.values()
        for m in motors:
            m.position = 0

    def at_home(self, axis):
        """True if the axis's home switch is actuated (NC open = HIGH)."""
        pin = self.home_pins.get(axis)
        if pin is None:
            return False
        with TX_LOCK:                      # same lgpio instance the pulse threads use
            return lgpio.gpio_read(self.h, pin) == 1

    def _stable_home(self, axis, want, n=4, poll=0.003):
        """True once at_home(axis) equals `want` for `n` consecutive reads.

        Debounces the switch so the fine approach seats firmly past the noisy
        trigger edge instead of stopping on the first flicker -- an axis that
        rests right on the threshold (x) then ends up solidly on the switch,
        exactly like one with margin (y).
        """
        for _ in range(n):
            if self.at_home(axis) != want:
                return False
            time.sleep(poll)
        return True

    def _pressed(self, axis, reads, need, poll):
        """True if the switch reads HIGH at least `need` times in `reads` reads (not consecutive).

        Tolerates a worn contact that chatters while pressed (HIGH only now and then),
        yet an open switch at rest reads LOW every time, so `need` > 1 hits rejects noise.
        """
        hits = 0
        for i in range(reads):
            if self.at_home(axis):
                hits += 1
                if hits >= need:
                    return True
            if i + 1 < reads:
                time.sleep(poll)
        return False

    def find_home(self, axis, fast_pps=15000, slow_pps=500,
                  backoff=800, fine=8):
        """Seek the home switch and define that point as position 0.

        Fast approach to first touch -> back off until released (+ clearance)
        -> slow fine approach until the switch reads triggered (>=2 HIGH in ~40 ms: tolerates a chattering contact). Bails
        immediately (without zeroing) if the e-stop abort fires mid-seek.
        """
        c = self.cfg[axis]
        if axis not in self.home_pins:
            raise ValueError(f"axis {axis!r} has no home switch")
        m = self.motors[axis]
        hd = 1 if c.get("home_dir", -1) >= 0 else -1     # +/-1 toward the switch
        home = lambda: self.at_home(axis)
        # Debounced "confirmed at home" for the fast phase: a single raw read can
        # blip HIGH from step-pulse noise/vibration during fast motion, which
        # would end the fast approach (or skip it entirely) and crawl the rest of
        # the way at slow_pps. Require a few consecutive HIGH reads; while the
        # switch is open this returns on the first (LOW) read, so it costs
        # nothing during the approach.
        confirmed = lambda: self._pressed(axis, reads=4, need=2, poll=0.0004)

        # 1. fast approach to first touch (skip only if really on the switch)
        if not confirmed():
            m.home_seek(hd, fast_pps, confirmed)
        # 2. back off until released, plus a little clearance
        while home() and not self.abort.is_set():
            m.jog(-hd * fine, slow_pps)
        m.jog(-hd * backoff, slow_pps)
        # 3. slow fine approach until the switch is *solidly* pressed
        # Bounded: if the switch never reads solidly triggered (flaky contact / loose wire)
        # the motor would push into the hard stop forever, so give up after a little more
        # than the back-off distance and say why.
        pushed = 0
        while not self._pressed(axis, reads=80, need=2, poll=0.0005) and not self.abort.is_set():
            if pushed > backoff + FINE_SLACK_STEPS:
                log.error("find_home %s: switch never read stably triggered after %d steps", axis, pushed)
                raise RuntimeError(f"home switch {axis.upper()} does not read stably (loose wire / "
                                   "bouncing contact?): stopped instead of pushing on")
            m.jog(hd * fine, slow_pps)
            pushed += fine
        if self.abort.is_set():            # e-stopped: don't claim a home
            return
        m.position = 0
        self.homed.add(axis)               # enable soft limits for this axis

    def angles(self):
        return {name: round(m.angle, 1) for name, m in self.motors.items()}

    def close(self):
        ANCHOR.release()
        for m in self.motors.values():
            m.close()
        for pin in self.home_pins.values():
            lgpio.gpio_free(self.h, pin)
        lgpio.gpio_free(self.h, self.enable_pin)
        if ANCHOR_PIN is not None:
            lgpio.gpio_free(self.h, ANCHOR_PIN)
        lgpio.gpiochip_close(self.h)

    def __enter__(self):
        return self

    def __exit__(self, *exc):
        self.close()
