Quezka/moneysort/moneysort/interface/cli.py

#!/usr/bin/env python3
"""Drive the arm via the daemon (armd) over HTTP. The daemon owns the GPIO.

Single axis : python3 arm_test.py <x|y|z> [steps] [pps]
Multi axis  : python3 arm_test.py x:400 y:-800 z:1200 [pps]   (any arg with ':')
Home an axis: python3 arm_test.py home <x|y|z>
Move to xyz : python3 arm_test.py moveto <X> <Y> <Z> [pps]    (tool tip, mm, via IK)

    steps : signed step count (+ / - sets direction), default 800
    pps   : cruise pulses per second, default 20000
    X Y Z : tool-tip target in the base frame, millimetres

See docs/USAGE.md for the full API (curl from any PC).
"""
import json
import sys
import urllib.error
import urllib.request

from moneysort.config import PORT

DEFAULT_PPS = 20000
BASE = f"http://localhost:{PORT}"


def build_request(args):
    """Parse argv into (path, payload, description)."""
    if args and args[0] == "home":
        axis = args[1] if len(args) > 1 else "y"
        return "/find_home", {"axis": axis}, f"find_home {axis}"
    if args and args[0] == "moveto":
        X, Y, Z = (float(args[i]) for i in (1, 2, 3))
        pps = int(args[4]) if len(args) > 4 else DEFAULT_PPS
        return "/move_to", {"x": X, "y": Y, "z": Z, "pps": pps}, f"move_to ({X},{Y},{Z}) @ {pps}"
    if args and ":" in args[0]:
        pps = DEFAULT_PPS
        if len(args) > 1 and ":" not in args[-1]:
            pps = int(args.pop())
        moves = {a.split(":")[0]: int(a.split(":")[1]) for a in args}
        return "/move", {"moves": moves, "pps": pps}, f"move_many {moves} @ {pps}"
    axis = args[0] if args else "y"
    steps = int(args[1]) if len(args) > 1 else 800
    pps = int(args[2]) if len(args) > 2 else DEFAULT_PPS
    return "/move", {"axis": axis, "steps": steps, "pps": pps}, f"move {axis} {steps} @ {pps}"


def main():
    url, payload, desc = build_request(sys.argv[1:])
    req = urllib.request.Request(
        BASE + url, data=json.dumps(payload).encode(),
        headers={"Content-Type": "application/json"}, method="POST",
    )
    print("POST", url + ":", desc, "...")
    try:
        print("result:", json.load(urllib.request.urlopen(req, timeout=120)))
    except urllib.error.HTTPError as e:
        print("rejected:", e.read().decode())
    except Exception as e:
        print("error:", e, "(is armd running?)")


if __name__ == "__main__":
    main()
