Quezka/moneysort/moneysort/hardware/stepper.py

#!/usr/bin/env python3
"""Reusable stepper control for STEP/DIR drivers (2DM442), using lgpio.

Why lgpio instead of a Python sleep() loop: hand-timing pulses with time.sleep()
tops out around 1-2 kHz because the OS scheduler can't sleep for less than
~50-100 us. lgpio.tx_pulse() generates the pulse train with hardware-assisted
timing, so we can push tens of kHz and get smooth, fast motion.

Speed control uses a trapezoidal profile: the move is split into a ramp-up, a
cruise, and a ramp-down, each queued as one or more tx_pulse "bursts" that lgpio
plays back-to-back. Ramping avoids stalling the motor by asking it to jump
straight to full speed from a standstill.

Wiring (direct 3.3V common-cathode - no level shifter needed):
    STEP gpio -> PUL+     DIR gpio -> DIR+
    all '-' terminals bussed to Pi GND
"""
import logging
import threading
import time
import lgpio

from moneysort.domain import planning

TX_PWM = 0  # lgpio kind selector for tx_busy / tx_room
log = logging.getLogger("armd.stepper")

# lgpio's tx queue is shared mutable state in C. The move thread queues pulses while HTTP threads
# poll tx_busy / tx_room for /status (dashboard every second, scripts at every move); concurrent
# calls can corrupt it and leave every axis "busy, room 0" until the process restarts. So every
# tx_* call (and the home-switch read) goes through this one lock. Calls are microseconds long.
TX_LOCK = threading.RLock()

TX_SLOTS = 10            # LG_TX_BUF in lgpio: queue entries per GPIO (tx_room == this -> no active record)
ANCHOR_PERIOD_US = 20000


class TxAnchor:
    """Keeps lgpio's pulse thread from wedging (the real cause of "TX queues stuck").

    lgpio (0.2.2, lgPthTx.c) keeps one record per pulsing GPIO in a list, newest first, and its single
    timing thread walks the list. When it deletes a *finished head record* it ends the walk early, so the
    records behind it are skipped for a pass, fall ~20 ms behind and produce a huge negative delay; that is
    added to a timespec whose tv_nsec then goes negative, clock_nanosleep() returns EINVAL, and the thread
    spins in `while (clock_nanosleep(...));` for ever (100% CPU, nothing drains, only a restart helps).
    It needs a finished head with another axis still running behind it: with three axes of different
    lengths, that is every few dozen moves (and when a jog ends).

    So an always-active record is kept at the head: a silent pulse train (`on = 0`: just writes LOW) on a spare
    GPIO. Every time an axis gets a NEW record it is inserted at the head, so the anchor is re-created right
    after (refresh) to stay newest. Axis records then never sit at the head, and the one deletion that
    does happen at the head (the anchor, once all axes are idle) has nothing active behind it.
    """

    def __init__(self):
        self.h = None
        self.pin = None
        self.active = False
        self.steppers = []
        self._idle = 0
        self._thread = None

    def configured(self):
        return self.pin is not None

    def setup(self, h, pin, steppers):
        self.h, self.pin, self.steppers = h, pin, list(steppers)
        lgpio.gpio_claim_output(h, pin, 0)
        if self._thread is None:
            self._thread = threading.Thread(target=self._watch, daemon=True)
            self._thread.start()

    def refresh(self):
        """(Re)create the anchor so it is the newest record (the head of lgpio's list)."""
        if not self.configured():
            return
        with TX_LOCK:
            if self.active:
                lgpio.tx_pulse(self.h, self.pin, 0, 0, 0, 0)          # old one off (it becomes a non-head)
            lgpio.tx_pulse(self.h, self.pin, 0, ANCHOR_PERIOD_US, 0, 0)   # new silent record at the head
            self.active = True

    def release(self):
        if not self.configured():
            return
        with TX_LOCK:
            if self.active:
                lgpio.tx_pulse(self.h, self.pin, 0, 0, 0, 0)
                self.active = False

    def _watch(self):
        """Switch the anchor off once every axis has been idle for a moment (no CPU wasted)."""
        while True:
            time.sleep(0.05)
            with TX_LOCK:
                if not self.active:
                    continue
                if any(s.busy() for s in self.steppers):
                    self._idle = 0
                    continue
                self._idle += 1
                if self._idle >= 2:
                    self.release()
                    self._idle = 0

    def alive(self, timeout=0.6):
        """Is lgpio's pulse thread still running? Queue a 10 ms silent train and see if it finishes.

        A cancelled queue looks empty (room 10, not busy) even when the thread is dead, so this is the
        only reliable check after a "TX queue stuck": False means only a restart will help.
        """
        if not self.configured():
            return True
        self.release()
        with TX_LOCK:
            lgpio.tx_pulse(self.h, self.pin, 0, 2000, 0, 5)
        t0 = time.monotonic()
        while time.monotonic() - t0 < timeout:
            with TX_LOCK:
                if not lgpio.tx_busy(self.h, self.pin, TX_PWM):
                    return True
            time.sleep(0.01)
        return False


ANCHOR = TxAnchor()

# lgpio can't cancel a queued train, so nothing here may wait forever on one: every
# wait is bounded, and a stuck queue becomes an error you can read, not a silent hang.
ROOM_TIMEOUT_S = 5.0     # max wait for a free slot in the tx queue
DRAIN_TIMEOUT_S = 30.0   # max wait for queued bursts to finish playing
DIR_FLIP_TIMEOUT_S = 1.0  # jog: max wait for the queue before reversing DIR (slices are 40 ms)


class Stepper:
    def __init__(self, handle, step_pin, dir_pin, en_pin=None,
                 steps_per_rev=200, microsteps=1, invert_dir=False,
                 min_pps=400, max_pps=20000, accel_steps=800, abort=None):
        """
        handle        : open gpiochip handle (lgpio.gpiochip_open(0))
        step_pin      : BCM gpio wired to PUL+
        dir_pin       : BCM gpio wired to DIR+
        en_pin        : BCM gpio wired to ENA+ (optional)
        steps_per_rev : motor full steps/rev (NEMA 17 = 200)
        microsteps    : driver microstep setting (set by the DIP switches)
        invert_dir    : flip if positive moves the "wrong" way
        min_pps       : starting/ending pulse rate of the ramp
        max_pps       : cruise pulse rate
        accel_steps   : how many steps the ramp-up (and ramp-down) span
        abort         : shared threading.Event; when set, any in-flight move
                        bails out and truncates its pulse train (emergency stop)
        """
        self.h = handle
        self.step_pin = step_pin
        self.dir_pin = dir_pin
        self.en_pin = en_pin
        self.invert_dir = invert_dir
        self.eff_spr = steps_per_rev * microsteps   # effective steps per rev
        self.min_pps = min_pps
        self.max_pps = max_pps
        self.accel_steps = accel_steps
        self.abort = abort if abort is not None else threading.Event()
        self.position = 0                           # net steps from home
        self._dir_level = None                      # last DIR level written (jog slices)

        lgpio.gpio_claim_output(handle, step_pin, 0)
        lgpio.gpio_claim_output(handle, dir_pin, 0)
        if en_pin is not None:
            lgpio.gpio_claim_output(handle, en_pin, 0)

    # --- internals --------------------------------------------------------
    def _tx(self, pps, cycles, *, honour_abort=True, timeout=ROOM_TIMEOUT_S):
        """tx_pulse that waits for queue room and retries "TX queue full".

        Returns True once queued; False if the e-stop fired first (honour_abort);
        raises RuntimeError if the queue stays full for `timeout` s (a train that
        never ends is hogging it) instead of hanging or leaking lgpio's error.
        """
        half = max(int(round(1_000_000 / pps / 2)), 1)   # microseconds, >=1
        t0 = time.monotonic()
        while True:
            if honour_abort and self.abort.is_set():     # e-stop: stop feeding
                return False
            with TX_LOCK:
                try:
                    room = lgpio.tx_room(self.h, self.step_pin, TX_PWM)
                    if room >= 1:
                        lgpio.tx_pulse(self.h, self.step_pin, half, half, 0, cycles)
                        if room >= TX_SLOTS:                 # no active record: this call created one (at the head)
                            ANCHOR.refresh()                 # ...so put the anchor back in front of it
                        return True
                except lgpio.error as e:                 # queue full
                    if "full" not in str(e).lower():
                        raise
            if time.monotonic() - t0 > timeout:
                if timeout > 0:
                    log.error("tx stuck on GPIO%d: tx_room=%s tx_busy=%s", self.step_pin,
                              lgpio.tx_room(self.h, self.step_pin, TX_PWM),
                              lgpio.tx_busy(self.h, self.step_pin, TX_PWM))   # raw values: a negative = lgpio error code
                    self.cancel()                        # free the axis; the caller still gets the error
                raise RuntimeError(f"TX queue stuck on GPIO{self.step_pin}: a pulse train is "
                                   "not finishing (e-stop, then restart moneysort-arm if it persists)")
            time.sleep(0.001)

    def cancel(self):
        """Hard stop: switch the pulse output off and delete everything queued.

        lgpio's documented way (tx_pulse with on = off = 0). Unlike halt() it works
        even when the queue is full or wedged -- the last resort that frees an axis
        without restarting the daemon. Pending steps are lost, so position is unsure.
        """
        with TX_LOCK:
            before = self.tx_state()
            try:
                lgpio.tx_pulse(self.h, self.step_pin, 0, 0, 0, 0)
            except lgpio.error as e:
                log.error("cancel: GPIO%d: %s", self.step_pin, e)
                return False
            log.warning("cancelled the pulse queue on GPIO%d (before: %s, after: %s)",
                        self.step_pin, before, self.tx_state())
        return True

    def room(self):
        """Free slots in the tx queue (<1 on an idle axis = the lgpio queue is wedged)."""
        with TX_LOCK:
            return lgpio.tx_room(self.h, self.step_pin, TX_PWM)

    def tx_state(self):
        """Raw tx_room/tx_busy for the log (a negative number is an lgpio error code)."""
        with TX_LOCK:
            return f"room={lgpio.tx_room(self.h, self.step_pin, TX_PWM)} busy={lgpio.tx_busy(self.h, self.step_pin, TX_PWM)}"

    def _burst(self, pps, cycles):
        """Queue one constant-rate burst of `cycles` pulses at `pps` (blocking)."""
        if cycles <= 0 or self.abort.is_set():
            return
        self._tx(pps, cycles)

    def drain(self, timeout=DRAIN_TIMEOUT_S, poll=0.005):
        """Wait for every queued burst to finish playing (bounded)."""
        t0 = time.monotonic()
        while self.busy():
            if time.monotonic() - t0 > timeout:
                raise RuntimeError(f"TX queue on GPIO{self.step_pin} still busy after {timeout:.0f}s")
            time.sleep(poll)

    def halt(self, wait=1.0):
        """Stop a running (possibly infinite) pulse train.

        lgpio ends an infinite burst when another pulse is queued behind it, so
        queue one final cycle (waiting up to `wait` s for room). Safe to call any
        time -- e-stop does, for every axis. Returns False if it could not.
        """
        try:
            return self._tx(self.min_pps, 1, honour_abort=False, timeout=wait)
        except RuntimeError:
            log.error("halt: could not stop the pulse train on GPIO%d (queue full)", self.step_pin)
            return self.cancel()


    def plan(self, steps, max_pps=None):
        """Build a move: returns (dir_level, [(pps, cycles), ...]).

        The magnitude profile comes from the pure planning module; this adds the
        hardware direction bit (sign of steps XOR the wiring invert). Shared by
        move() and Arm.move_many(); the latter interleaves several steppers'
        segment lists to drive multiple axes at once.
        """
        max_pps = max_pps or self.max_pps
        level = (1 if steps < 0 else 0) ^ int(self.invert_dir)
        segs = planning.plan_segments(steps, max_pps, self.min_pps, self.accel_steps)
        return level, segs

    def set_dir(self, level):
        lgpio.gpio_write(self.h, self.dir_pin, level)
        self._dir_level = level

    def try_queue(self, pps, cycles):
        """Non-blocking: queue one burst if the tx queue has room, else False."""
        if cycles <= 0:
            return True
        with TX_LOCK:
            if lgpio.tx_room(self.h, self.step_pin, TX_PWM) < 1:
                return False
        try:
            self._tx(pps, cycles, timeout=0.0)
        except RuntimeError:
            return False
        return True

    def busy(self):
        with TX_LOCK:
            v = lgpio.tx_busy(self.h, self.step_pin, TX_PWM)
        if v < 0:                                  # an lgpio error code is not "busy" (it is truthy!)
            log.error("tx_busy on GPIO%d returned error %s", self.step_pin, v)
            return False
        return bool(v)

    # --- public API -------------------------------------------------------
    def move(self, steps, max_pps=None):
        """Move a signed number of steps (+/-) with a trapezoidal ramp (blocking).

        If the abort event fires mid-move it stops feeding bursts, truncates the
        pulse train, and leaves position unchanged (the true stop point is
        unknown -- the caller should treat the axis as no longer homed).
        """
        if steps == 0:
            return
        level, segs = self.plan(steps, max_pps)
        self.set_dir(level)
        time.sleep(0.001)                     # DIR setup time
        for pps, cyc in segs:
            if self.abort.is_set():           # e-stop: stop queuing new bursts
                break
            self._burst(pps, cyc)
        self.drain()                          # what's queued (bursts are short: quick on abort)
        if not self.abort.is_set():
            self.position += steps

    def move_degrees(self, degrees, max_pps=None):
        self.move(round(degrees / 360.0 * self.eff_spr), max_pps=max_pps)

    def go_home(self, max_pps=None):
        self.move(-self.position, max_pps=max_pps)

    def queue_slice(self, steps, dt):
        """Queue `steps` (signed) to play over `dt` seconds, without waiting for them.

        For continuous jogging: the caller feeds one short slice per tick, so the
        motor keeps running at the commanded speed between ticks. A direction
        change first lets the queue drain (never flip DIR under a running train).
        Position is advanced at queue time (an e-stop un-homes everything anyway).
        """
        if steps == 0 or self.abort.is_set():
            return
        level = (1 if steps < 0 else 0) ^ int(self.invert_dir)
        if level != self._dir_level:
            t0 = time.monotonic()
            while self.busy() and not self.abort.is_set():
                if time.monotonic() - t0 > DIR_FLIP_TIMEOUT_S:
                    self.cancel()                  # a 40 ms slice never takes this long: wedged
                    raise RuntimeError(f"TX queue on GPIO{self.step_pin} not draining (cleared)")
                time.sleep(0.002)
            self.set_dir(level)
            time.sleep(0.001)                  # DIR setup time
        n = abs(steps)
        self._burst(min(max(n / dt, 1), self.max_pps), n)
        self.position += steps

    def jog(self, steps, pps):
        """Constant-speed move with no accel ramp -- for slow homing chunks."""
        if steps == 0 or self.abort.is_set():
            return
        level = (1 if steps < 0 else 0) ^ int(self.invert_dir)
        self.set_dir(level)
        time.sleep(0.001)
        self._burst(pps, abs(steps))
        self.drain()
        if not self.abort.is_set():
            self.position += steps

    def home_seek(self, direction, pps, stop_fn, accel_steps=400,
                  poll=0.0005):
        """Ramp up toward `direction` and run until stop_fn() is True.

        For the fast phase of homing: ramps to `pps` (no stall), cruises
        indefinitely while polling stop_fn(), then halts promptly on contact.
        Position is NOT tracked here -- the caller re-zeroes at the switch.
        """
        level = (1 if direction < 0 else 0) ^ int(self.invert_dir)
        self.set_dir(level)
        time.sleep(0.001)
        stopped = False

        # queue ramp-up bursts then one infinite cruise burst (cyc=0), polling for
        # queue room + trigger so we can bail during the ramp too. The `finally`
        # ALWAYS ends the infinite burst -- even on an exception or when the switch
        # trips while the queue is still full of ramp bursts (the old unchecked
        # tx_pulse raised "TX queue full" there and left the train running forever).
        try:
            for p, cyc in planning.ramp_segs(accel_steps, pps, self.min_pps, up=True) + [(pps, 0)]:
                if not self._tx(p, cyc, timeout=ROOM_TIMEOUT_S):
                    stopped = True                # e-stop while waiting for room
                    break
            while not stopped:                    # cruise: poll until trigger
                if stop_fn() or self.abort.is_set():
                    break
                time.sleep(poll)
        finally:
            self.halt(wait=3.0)                   # queue the final cycle behind the infinite one
            try:
                self.drain(timeout=5.0, poll=0.001)
            except RuntimeError as e:
                log.error("home_seek: %s", e)

    @property
    def angle(self):
        return self.position / self.eff_spr * 360.0

    def close(self):
        # move() already waits for the train to finish, so just park low & free.
        lgpio.gpio_write(self.h, self.step_pin, 0)
        lgpio.gpio_free(self.h, self.step_pin)
        lgpio.gpio_free(self.h, self.dir_pin)
        if self.en_pin is not None:
            lgpio.gpio_free(self.h, self.en_pin)
