Quezka/moneysort/moneysort/interface/dashboard.py

#!/usr/bin/env python3
"""Dashboard presentation: the HTML PAGE plus system-metric helpers.

Pure presentation/telemetry for the Money Sorter web UI, dependency-free (Python
standard library plus the pure ``domain.kinematics`` link lengths for the 3D view). The armd server (``interface/server.py``) imports
``PAGE`` and these helpers, owns the arm, and assembles ``/status``. This module
touches no GPIO and runs no server of its own.
"""
import json
import os
import socket
import subprocess

from moneysort.domain import kinematics


# --- metric collection ------------------------------------------------------
def _read(path, default=""):
    try:
        with open(path) as f:
            return f.read().strip()
    except OSError:
        return default


def cpu_temp_c():
    raw = _read("/sys/class/thermal/thermal_zone0/temp", "0")
    try:
        return round(int(raw) / 1000.0, 1)
    except ValueError:
        return None


def load_avg():
    try:
        return float(_read("/proc/loadavg", "0").split()[0])
    except (ValueError, IndexError):
        return None


def mem_pct():
    info = {}
    for line in _read("/proc/meminfo").splitlines():
        parts = line.split(":")
        if len(parts) == 2:
            info[parts[0]] = int(parts[1].strip().split()[0])
    total, avail = info.get("MemTotal"), info.get("MemAvailable")
    if total and avail:
        return round((total - avail) / total * 100), round(total / 1_048_576, 1)
    return None, None


def disk_pct():
    try:
        s = os.statvfs("/")
        used = (s.f_blocks - s.f_bfree) * s.f_frsize
        total = s.f_blocks * s.f_frsize
        return round(used / total * 100), round(total / 1_000_000_000, 1)
    except OSError:
        return None, None


def uptime_str():
    try:
        secs = int(float(_read("/proc/uptime", "0").split()[0]))
    except (ValueError, IndexError):
        return "?"
    d, rem = divmod(secs, 86400)
    h, rem = divmod(rem, 3600)
    m = rem // 60
    return (f"{d}d " if d else "") + f"{h}h {m}m"


def ip_addr():
    try:
        s = socket.socket(socket.AF_INET, socket.SOCK_DGRAM)
        s.connect(("8.8.8.8", 80))
        ip = s.getsockname()[0]
        s.close()
        return ip
    except OSError:
        return "?"


def system_action(action):
    """Reboot or power off the Pi (needs passwordless sudo)."""
    cmd = {"reboot": ["sudo", "reboot"], "poweroff": ["sudo", "poweroff"]}.get(action)
    if not cmd:
        return False
    try:
        subprocess.Popen(cmd)   # fire-and-forget; the box goes down under us
        return True
    except OSError:
        return False


def exit_kiosk():
    """Close the fullscreen kiosk (cog or Chromium), returning to the desktop."""
    try:
        subprocess.Popen(["pkill", "-f", "chromium"])
        subprocess.Popen(["pkill", "-x", "cog"])
        return True
    except OSError:
        return False


# --- page -------------------------------------------------------------------
PAGE = """<!doctype html><html lang="it"><head>
<meta charset="utf-8"><meta name="viewport" content="width=device-width,initial-scale=1">
<title>Money Sorter</title>
<style>
  :root { color-scheme: dark; }
  * { box-sizing: border-box; margin: 0; padding: 0; }
  body { font-family: system-ui, sans-serif; background: #0e1116; color: #e6edf3;
         height: 100vh; overflow: hidden; padding: 10px; }
  header { display: flex; align-items: baseline; justify-content: space-between; margin-bottom: 8px; }
  h1 { font-size: 22px; font-weight: 700; letter-spacing: .5px; }
  h1 span { color: #58a6ff; }
  .clock { font-size: 18px; color: #8b949e; font-variant-numeric: tabular-nums; }
  .grid { display: grid; grid-template-columns: repeat(6, 1fr); gap: 10px; }
  .card { background: #161b22; border: 1px solid #21262d; border-radius: 12px; padding: 8px 11px; }
  .label { font-size: 11px; text-transform: uppercase; letter-spacing: 1px; color: #8b949e; margin-bottom: 2px; }
  .value { font-size: 22px; font-weight: 700; font-variant-numeric: tabular-nums; }
  .unit { font-size: 14px; color: #8b949e; font-weight: 500; }
  .sub { font-size: 11px; color: #6e7681; margin-top: 1px; }
  .ok { color: #3fb950; } .warn { color: #d29922; } .bad { color: #f85149; }
  .section { font-size: 14px; text-transform: uppercase; letter-spacing: 1.5px;
             color: #8b949e; margin: 10px 0 6px; display: flex; align-items: center; gap: 10px; }
  .dot { width: 10px; height: 10px; border-radius: 50%; background: #6e7681; }
  .dot.live { background: #3fb950; box-shadow: 0 0 8px #3fb950; }
  .joints { display: grid; grid-template-columns: repeat(3, 1fr); gap: 10px; }
  .cammain { display: flex; gap: 14px; align-items: flex-start; margin-top: 4px; flex-wrap: wrap; }
  .camcol { flex: 0 0 auto; }
  .infocol { flex: 1 1 260px; min-width: 240px; display: flex; flex-direction: column; gap: 10px; }
  .infocol .section { margin: 0 0 -4px; }
  .xyz { display: grid; grid-template-columns: repeat(3, 1fr); gap: 8px; }
  .xyz .value { font-size: 24px; }
  .badges { display: flex; gap: 8px; flex-wrap: wrap; margin-top: 4px; }
  .badge { padding: 3px 10px; border-radius: 999px; font-size: 13px; font-weight: 700;
           background: #21262d; color: #6e7681; border: 1px solid #30363d; }
  .badge.on { background: #15271a; color: #3fb950; border-color: #238636; }
  .badge.warn { background: #2a2413; color: #d29922; border-color: #7d5f13; }
  .coins { max-height: 150px; overflow: hidden; font-size: 14px; font-variant-numeric: tabular-nums; }
  .coin { display: flex; justify-content: space-between; gap: 8px; padding: 3px 0; border-top: 1px solid #21262d; }
  .coin:first-child { border-top: none; }
  .ctrlcol { flex: 0 0 220px; margin-left: auto; display: flex; flex-direction: column; gap: 8px; }
  .controls.vert { flex-direction: column; align-items: stretch; margin-top: 0; gap: 8px; }
  .controls.vert button { width: 100%; }
  .controls.vert .estop { font-size: 15px; padding: 11px 12px; letter-spacing: .5px; }
  .controls.vert .sys, .controls.vert .reenable { font-size: 14px; padding: 9px 12px; }
  .camwrap { position: relative; background: #0d1117; border: 1px solid #21262d;
             border-radius: 14px; overflow: hidden; aspect-ratio: 1/1; width: 340px; max-width: 46vw; }
  .cam { width: 100%; height: 100%; object-fit: contain; display: block; }
  /* 3D open: the panel fills the whole screen (explicit offsets, no inset: old kiosk WebKit) */
  .camwrap.big { position: fixed; left: 0; top: 0; width: 100vw; height: 100vh; max-width: none; z-index: 50;
                 border: none; border-radius: 0; aspect-ratio: auto; }
  .bigstop { display: none; position: absolute; left: 10px; top: 8px; z-index: 2; padding: 8px 16px; font-size: 15px;
             background: #da3633; border-radius: 10px; box-shadow: 0 3px 0 #a5201d; }
  .camwrap.big .bigstop { display: block; }
  .camwrap.big .viewbtn { padding: 10px 20px; font-size: 16px; }
  #v3d { position: absolute; left: 0; top: 0; width: 100%; height: 100%; display: none; touch-action: none; }
  .viewbtn { position: absolute; top: 8px; right: 8px; z-index: 2; padding: 6px 14px; font-size: 14px;
             background: #30363d; border-radius: 10px; opacity: .92; }
  .camoff { position: absolute; inset: 0; display: flex; align-items: center;
            justify-content: center; color: #6e7681; font-size: 15px; }
  .joint .value { font-size: 26px; }
  .moving { color: #58a6ff; } .idle { color: #6e7681; }
  .controls { display: flex; align-items: center; gap: 14px; margin-top: 22px; }
  .spacer { flex: 1; }
  button { touch-action: manipulation; font-family: inherit; font-weight: 700; border: none; border-radius: 12px;
           cursor: pointer; color: #fff; -webkit-tap-highlight-color: transparent; }
  button:active { transform: translateY(3px); box-shadow: none !important; }
  .estop { background: #da3633; font-size: 22px; letter-spacing: 1px; padding: 20px 34px; box-shadow: 0 4px 0 #a5201d; }
  .estop.off { background: #3d1d1d; color: #f85149; box-shadow: 0 4px 0 #2a1414; }
  .reenable { background: #238636; font-size: 16px; padding: 16px 22px; box-shadow: 0 4px 0 #196c2b; }
  .sys { background: #30363d; font-size: 16px; padding: 16px 22px; box-shadow: 0 4px 0 #21262d; }
  .sys.danger { background: #6e2b2b; box-shadow: 0 4px 0 #4a1d1d; }
  .sys.go { background: #1f6feb; box-shadow: 0 4px 0 #164a9e; }
  .settings { margin-top: 2px; border-top: 1px solid #21262d; padding-top: 4px; }
  .settings > summary { list-style: none; cursor: pointer; color: #8b949e; font-size: 13px;
             text-transform: uppercase; letter-spacing: 1.5px; padding: 8px 0; }
  .settings > summary::-webkit-details-marker { display: none; }
  .settings[open] > summary { color: #c9d1d9; }
  .settings .controls { margin-top: 8px; }
  /* explicit offsets / width, no inset / min(): the kiosk's old WebKit may not know them
     and then the dialog lands off-screen -- buttons seem to "do nothing" */
  #modal { position: fixed; top: 0; left: 0; right: 0; bottom: 0; width: 100%; height: 100%;
           background: rgba(0,0,0,.65); display: none;
           align-items: center; justify-content: center; z-index: 200; }
  #modal.show { display: flex; }
  .dialog { background: #161b22; border: 1px solid #30363d; border-radius: 16px; padding: 26px 30px;
            width: 90%; max-width: 560px; box-shadow: 0 20px 60px rgba(0,0,0,.7); }
  .dialog p { font-size: 20px; line-height: 1.35; margin-bottom: 22px; }
  .dialog .row { display: flex; }
  .dialog button { flex: 1; font-size: 19px; padding: 16px 12px; margin: 0 7px; }
  .dialog .cancel { background: #30363d; box-shadow: 0 4px 0 #21262d; }
  .dialog .okbtn { background: #1f6feb; box-shadow: 0 4px 0 #164a9e; }
  .dialog .okbtn.danger { background: #da3633; box-shadow: 0 4px 0 #a5201d; }
  #toasts { position: fixed; top: 24px; left: 50%; transform: translateX(-50%);
            display: flex; flex-direction: column; align-items: center; gap: 12px;
            z-index: 100; pointer-events: none; width: max-content; max-width: 92vw; }
  .toast { min-width: 320px; max-width: 620px; background: #1b2230; border: 1px solid #30363d;
           border-left: 7px solid #58a6ff; border-radius: 13px; padding: 19px 28px; color: #f0f3f6;
           font-size: 21px; font-weight: 700; letter-spacing: .2px; box-shadow: 0 16px 44px rgba(0,0,0,.6);
           display: flex; align-items: center; gap: 15px;
           opacity: 0; transform: translateY(-18px) scale(.95);
           transition: opacity .22s ease, transform .22s cubic-bezier(.2,.9,.3,1.3); }
  .toast.show { opacity: 1; transform: none; }
  .toast .ico { font-size: 26px; line-height: 1; }
  .toast.info    { border-left-color: #58a6ff; background: #172234; } .toast.info    .ico { color: #58a6ff; }
  .toast.success { border-left-color: #3fb950; background: #15271a; } .toast.success .ico { color: #3fb950; }
  .toast.warn    { border-left-color: #d29922; background: #2a2413; } .toast.warn    .ico { color: #d29922; }
  .toast.error   { border-left-color: #f85149; background: #2c1919; } .toast.error   .ico { color: #f85149; }
</style></head><body>
  <div id="jserr" style="display:none;position:fixed;left:0;right:0;bottom:0;z-index:999;background:#7d1512;color:#fff;
       font:14px monospace;padding:8px 12px;white-space:pre-wrap"></div>
  <script>
    // The kiosk has no console: show page errors on screen so "it does nothing" has a reason.
    (function () {
      function show(m) { var e = document.getElementById("jserr"); if (!e) return;
        e.style.display = "block"; e.textContent = "JS: " + m; }
      window.onerror = function (msg, src, line, col) { show(msg + " (line " + line + ":" + col + ")"); };
      // Tap fallback. Diagnosed on the kiosk (WPE WebKit 2.48): a tap on a button delivers
      // pointerdown/mousedown/pointerup/mouseup but NO "click" (and no touch events), so every
      // onclick handler stayed silent. If a press and release land on the same button and no
      // native click follows, click it ourselves.
      var lastClick = 0, down = null;
      function xy(e) { var t = (e.changedTouches && e.changedTouches[0]) || (e.touches && e.touches[0]) || e;
        return [t.clientX, t.clientY]; }
      function btnOf(e) { return e.target && e.target.closest ? e.target.closest("button, summary") : null; }
      document.addEventListener("click", function () { lastClick = Date.now(); }, true);
      ["pointerdown", "mousedown", "touchstart"].forEach(function (n) {
        document.addEventListener(n, function (e) {
          var b = btnOf(e); down = b ? { b: b, p: xy(e) } : null;
        }, true);
      });
      ["pointerup", "mouseup", "touchend"].forEach(function (n) {
        document.addEventListener(n, function (e) {
          var b = btnOf(e), p = xy(e);
          if (!down || !b || b !== down.b || Math.abs(p[0] - down.p[0]) > 20 || Math.abs(p[1] - down.p[1]) > 20) return;
          var at = Date.now();
          setTimeout(function () { if (lastClick < at) b.click(); }, 150);   // pointerup+mouseup: 2nd sees the 1st click
        }, true);
      });
      window.addEventListener("unhandledrejection", function (ev) { show("promise: " + (ev.reason && ev.reason.message || ev.reason)); });
    })();
  </script>
  <div id="toasts"></div>
  <div id="modal"><div class="dialog">
    <p id="modalmsg"></p>
    <div class="row"><button id="modalcancel" class="cancel" data-t>Cancel</button>
                     <button id="modalok" class="okbtn" data-t>Confirm</button></div>
  </div></div>
  <header>
    <h1>Money<span>Sorter</span></h1>
    <div class="clock"><span id="ver" style="font-size:12px;color:#6e7681;margin-right:12px"></span><span id="clock">--:--:--</span></div>
  </header>

  <div class="grid" id="sys"></div>

  <div class="section"><span class="dot" id="armdot"></span><span data-t>Robot Arm</span> <span id="armstate" class="idle" style="font-size:13px"></span></div>
  <div class="joints" id="joints"></div>
  <div class="sub" id="lasterr" style="margin-top:4px"></div>

  <div class="cammain">
    <div class="camcol">
      <div class="section"><span class="dot" id="camdot"></span><span data-t>Camera</span> <span id="camstate" class="idle" style="font-size:13px"></span></div>
      <div class="camwrap" id="camwrap">
        <img id="cam" class="cam" alt="">
        <canvas id="v3d"></canvas>
        <button id="v3dbtn" class="viewbtn">3D</button>
        <button id="bigstop" class="bigstop">&#9940; STOP</button>
        <div id="camoff" class="camoff" data-t>camera offline</div>
      </div>
    </div>
    <div class="infocol">
      <div class="section"><span data-t>Tool position</span></div>
      <div class="card"><div class="xyz" id="tip"></div><div class="sub" id="reach"></div></div>
      <div class="section"><span data-t>Axes</span></div>
      <div class="card"><div class="badges" id="axes"></div></div>
      <div class="section"><span data-t>Coins detected</span> <span id="coincount" class="idle" style="font-size:13px"></span></div>
      <div class="card"><div class="coins" id="coins"></div><div class="badges" id="calstate"></div></div>
    </div>
    <div class="ctrlcol">
      <div class="controls vert">
        <button id="estop" class="estop">&#9940; <span data-t>EMERGENCY DISABLE</span></button>
        <button id="reenable" class="reenable" style="display:none" data-t>Re-enable motors</button>
        <button id="gozero" class="sys go">&#8617; <span data-t>Return to zero</span></button>
        <button id="zero" class="sys">&#9678; <span data-t>Set zero here</span></button>
        <button id="desktop" class="sys">&#128421; <span data-t>Desktop</span></button>
        <button id="reboot" class="sys">&#8635; <span data-t>Reboot</span></button>
        <button id="poweroff" class="sys danger">&#9099; <span data-t>Power off</span></button>
      </div>
      <details class="settings">
        <summary>&#9881; <span data-t>Settings</span></summary>
        <div class="controls vert">
          <button id="home" class="sys">&#8962; <span data-t>Home axes (seek switches)</span></button>
        </div>
      </details>
    </div>
  </div>

<script>
// The screen is in Italian; add ?lang=en to the address for English.
const IT = {
  "Tool position": "Posizione utensile", "Axes": "Assi", "Coins detected": "Monete rilevate",
  "reach": "sbraccio", "homed": "azzerato", "not homed": "non azzerato",
  "no coins in view": "nessuna moneta inquadrata", "calibrated": "calibrata",
  "not calibrated": "non calibrata", "away from survey pose": "fuori dalla posa di rilievo",
  "Cancel": "Annulla", "Confirm": "Conferma", "no depth": "senza profondità",
  "pulses still running on": "impulsi ancora attivi su", "press EMERGENCY DISABLE": "premi ARRESTO DI EMERGENZA",
  "The arm is not homed (its position is lost at every start). Home now? X and Y seek their switches; Z returns to zero.":
    "Il braccio non è azzerato (a ogni avvio perde la posizione). Eseguire l'homing ora? X e Y cercano i finecorsa; Z torna a zero.",
  "Recover (restart)": "Recupera (riavvia)", "Restart the arm daemon? Axes will need homing again.": "Riavviare il demone del braccio? Gli assi vanno rifatti in homing.", "Restarting the daemon…": "Riavvio del demone…",
  "Robot Arm": "Braccio robotico", "Camera": "Fotocamera", "camera offline": "fotocamera offline",
  "camera feed": "immagine della fotocamera",
  "EMERGENCY DISABLE": "ARRESTO DI EMERGENZA", "Re-enable motors": "Riattiva i motori",
  "Return to zero": "Torna a zero", "Set zero here": "Imposta zero qui", "Desktop": "Desktop",
  "Reboot": "Riavvia", "Power off": "Spegni", "Settings": "Impostazioni",
  "Home axes (seek switches)": "Azzera gli assi (cerca i finecorsa)",
  "CPU Temp": "Temp. CPU", "CPU Load": "Carico CPU", "1-min average": "media a 1 min",
  "Memory": "Memoria", "GB total": "GB totali", "Disk": "Disco", "Host": "Host", "Uptime": "Attivo da",
  "MOVING": "IN MOVIMENTO", "idle": "fermo", "updated {n}s ago": "aggiornato {n} s fa",
  "no data yet": "ancora nessun dato", "MOTORS DISABLED": "MOTORI DISATTIVATI",
  "live": "attiva", "offline": "offline", "no connection to arm": "nessuna connessione con il braccio",
  "Emergency stop — motors disabled": "Arresto di emergenza — motori disattivati",
  "Motors re-enabled": "Motori riattivati", "Re-enable failed": "Riattivazione non riuscita",
  "Motors are disabled — re-enable first": "I motori sono disattivati — riattivali prima",
  "Already at zero": "Già a zero", "Returning to zero…": "Ritorno a zero…",
  "Return failed": "Ritorno non riuscito", "Back at zero": "Tornato a zero",
  "Set current position as zero (new home reference)?": "Impostare la posizione attuale come zero (nuovo riferimento di origine)?",
  "Zero set at current position": "Zero impostato nella posizione attuale",
  "Failed to set zero": "Impossibile impostare lo zero",
  "Home all axes? X and Y seek their switches; Z returns to zero.": "Azzerare tutti gli assi? X e Y cercano i finecorsa; Z torna a zero.",
  "Homing axes…": "Azzeramento degli assi…", "Homing failed": "Azzeramento non riuscito",
  "Homing complete": "Azzeramento completato", "Exiting to desktop…": "Uscita al desktop…",
  "Reboot the Pi?": "Riavviare il Pi?", "Rebooting…": "Riavvio…",
  "Power OFF the Pi?": "Spegnere il Pi?", "Powering off…": "Spegnimento…",
};
const LANG = new URLSearchParams(location.search).get("lang") || "it";
const t = s => (LANG === "it" && IT[s]) || s;
document.documentElement.lang = LANG === "it" ? "it" : "en";
document.querySelectorAll("[data-t]").forEach(e => { e.textContent = t(e.textContent.trim()); });
document.getElementById("cam").alt = t("camera feed");

const cls = (v, warn, bad) => v == null ? "" : v >= bad ? "bad" : v >= warn ? "warn" : "ok";
const card = (label, value, unit, sub, klass="") =>
  `<div class="card"><div class="label">${label}</div>
   <div class="value ${klass}">${value ?? "&mdash;"}<span class="unit">${unit||""}</span></div>
   <div class="sub">${sub||""}</div></div>`;

let last = {};                       // most recent /status, for click-time checks

const ICON = { info: "&#8505;", success: "&#10003;", warn: "&#9888;", error: "&#10007;" };
function toast(msg, type = "info", ttl = 3800) {
  const wrap = document.getElementById("toasts");
  const el = document.createElement("div");
  el.className = "toast " + type;
  el.innerHTML = `<span class="ico">${ICON[type] || ICON.info}</span><span>${msg}</span>`;
  wrap.appendChild(el);
  requestAnimationFrame(() => el.classList.add("show"));
  setTimeout(() => { el.classList.remove("show"); setTimeout(() => el.remove(), 300); }, ttl);
}

let build = null;                    // daemon build id; reload the page if it changes
async function tick() {
  let d; try { d = await (await fetch("/status")).json(); } catch { return; }
  if (build && d.build && d.build !== build) { location.reload(); return; }
  build = d.build;
  last = d;
  document.getElementById("clock").textContent = d.time;
  document.getElementById("ver").textContent = d.version ? "v" + d.version : "";

  document.getElementById("sys").innerHTML =
    card(t("CPU Temp"), d.temp, "&deg;C", "", cls(d.temp, 65, 80)) +
    card(t("CPU Load"), d.load, "", t("1-min average")) +
    card(t("Memory"), d.mem_pct, "%", (d.mem_total||"?")+" "+t("GB total"), cls(d.mem_pct, 75, 90)) +
    card(t("Disk"), d.disk_pct, "%", (d.disk_total||"?")+" "+t("GB total"), cls(d.disk_pct, 80, 92)) +
    card(t("Host"), d.host, "", d.ip) +
    card(t("Uptime"), d.uptime, "", "");

  const a = d.arm, dot = document.getElementById("armdot"), st = document.getElementById("armstate");
  const names = ["x", "y", "z"];
  if (a) {
    dot.className = a.moving ? "dot live" : "dot";
    const age = a._age != null ? t("updated {n}s ago").replace("{n}", a._age) : "";
    st.textContent = a.moving ? t("MOVING") : (t("idle") + " · " + age);
    st.className = a.moving ? "moving" : "idle";
    document.getElementById("joints").innerHTML = names.map(n =>
      `<div class="card joint"><div class="label">${n}</div>
       <div class="value">${a.joints && a.joints[n]!=null ? a.joints[n] : "&mdash;"}<span class="unit">&deg;</span></div></div>`
    ).join("");
  } else {
    dot.className = "dot";
    st.textContent = t("no data yet");
    document.getElementById("joints").innerHTML = names.map(n =>
      `<div class="card joint"><div class="label">${n}</div><div class="value idle">&mdash;<span class="unit">&deg;</span></div></div>`
    ).join("");
  }

  const tip = a && a.tip, homedAx = (a && a.homed) || [];
  document.getElementById("tip").innerHTML = ["x", "y", "z"].map(k =>
    `<div><div class="label">${k.toUpperCase()}</div><div class="value">${tip ? tip[k] : "&mdash;"}<span class="unit"> mm</span></div></div>`).join("");
  document.getElementById("reach").textContent = tip ? t("reach") + " " + tip.r + " mm" : "";
  document.getElementById("axes").innerHTML = ["x", "y", "z"].map(k => {
    const on = k === "z" || homedAx.includes(k);     // z has no switch
    return `<span class="badge ${on ? "on" : "warn"}">${k.toUpperCase()} · ${on ? t("homed") : t("not homed")}</span>`;
  }).join("");

  const le = a && a.debug && a.debug.last_error;
  const stuck = a && a.debug && !a.moving && a.debug.tx_busy && a.debug.tx_busy.length;
  const txerr = le && /TX queue/.test(String(le[2]));
  document.getElementById("lasterr").innerHTML =
    (stuck ? `<span class="bad">&#9888; ${t("pulses still running on")} ${a.debug.tx_busy.join(", ").toUpperCase()} &mdash; ${t("press EMERGENCY DISABLE")}</span> ` : "") +
    (stuck ? `<button id="recoverbtn" style="padding:6px 14px;font-size:14px">${t("Recover (restart)")}</button> ` : "") +
    (le ? `<span class="warn">&#9888; ${le[0]} &middot; ${le[1]}: ${String(le[2]).replace(/</g, "&lt;")}</span>` : "");

  const en = d.motors_enabled, estop = document.getElementById("estop"), reen = document.getElementById("reenable");
  if (en === false) { estop.textContent = t("MOTORS DISABLED"); estop.classList.add("off"); reen.style.display = ""; }
  else if (en === true) { estop.innerHTML = "&#9940; " + t("EMERGENCY DISABLE"); estop.classList.remove("off"); reen.style.display = "none"; }

  const cam = d.camera || {}, cdot = document.getElementById("camdot");
  const cimg = document.getElementById("cam"), coff = document.getElementById("camoff");
  document.getElementById("calstate").innerHTML = cam.ok
    ? `<span class="badge ${cam.calibrated ? "on" : "warn"}">${cam.calibrated ? t("calibrated") : t("not calibrated")}</span>` : "";
  cdot.className = cam.ok ? "dot live" : "dot";
  document.getElementById("camstate").textContent = cam.ok ? (cam.desc || t("live")) : (cam.error || t("offline"));
  if (cam.ok) { coff.style.display = "none"; cimg.style.display = ""; }   // pollCam sets the image
  else { cimg.style.display = "none"; coff.style.display = ""; }
  kick3d();
}

document.getElementById("lasterr").onclick = async (e) => {
  if (!e.target || e.target.id !== "recoverbtn") return;
  if (!await ask(t("Restart the arm daemon? Axes will need homing again."))) return;
  toast(t("Restarting the daemon…"), "warn", 8000);
  post("/recover");
};

async function post(path, body) {
  try {
    const r = await fetch(path, {
      method: "POST",
      headers: body ? { "Content-Type": "application/json" } : {},
      body: body ? JSON.stringify(body) : undefined,
    });
    let j = {}; try { j = await r.json(); } catch {}
    return { ok: r.ok && j.ok !== false, ...j };
  } catch { return { ok: false, error: t("no connection to arm") }; }
}

const atZero = () => last.arm && last.arm.joints &&
  Object.values(last.arm.joints).every(v => v === 0);

document.getElementById("estop").onclick = async () => {
  await post("/disable");
  toast(t("Emergency stop — motors disabled"), "warn");
  tick();
};
document.getElementById("reenable").onclick = async () => {
  const r = await post("/enable");
  toast(r.ok ? t("Motors re-enabled") : (r.error || t("Re-enable failed")), r.ok ? "success" : "error");
  tick();
};
document.getElementById("gozero").onclick = async () => {
  if (last.estopped) { toast(t("Motors are disabled — re-enable first"), "warn"); return; }
  if (atZero()) { toast(t("Already at zero"), "info"); return; }
  toast(t("Returning to zero…"), "info");
  const r = await post("/return_zero");
  if (!r.ok) toast(r.error || t("Return failed"), "error");
  else if (!r.estopped) toast(t("Back at zero"), "success");
  tick();
};
// In-page confirm: kiosk browsers (cog) don't show window.confirm(), so buttons using it did nothing.
function ask(msg, danger = false) {
  return new Promise(resolve => {
    const m = document.getElementById("modal"), ok = document.getElementById("modalok"),
          no = document.getElementById("modalcancel");
    document.getElementById("modalmsg").textContent = msg;
    ok.classList.toggle("danger", danger);
    const done = v => { m.classList.remove("show"); ok.onclick = no.onclick = null; resolve(v); };
    ok.onclick = () => done(true);
    no.onclick = () => done(false);
    m.classList.add("show");
  });
}

document.getElementById("zero").onclick = async () => {
  if (!await ask(t("Set current position as zero (new home reference)?"))) return;
  const r = await post("/zero");
  toast(r.ok ? t("Zero set at current position") : (r.error || t("Failed to set zero")),
        r.ok ? "success" : "error");
  tick();
};
async function runHome() {
  toast(t("Homing axes…"), "info", 5000);
  const r = await post("/home");
  if (!r.ok) toast(r.error || t("Homing failed"), "error");
  else if (!r.estopped) toast(t("Homing complete"), "success");
  tick();
}
document.getElementById("home").onclick = async () => {
  if (last.estopped) { toast(t("Motors are disabled — re-enable first"), "warn"); return; }
  if (!await ask(t("Home all axes? X and Y seek their switches; Z returns to zero."))) return;
  runHome();
};

// After every start the arm's position is unknown (steppers are open-loop and the daemon forgets it).
// Offer to home as soon as the dashboard sees an un-homed arm; one question per un-homed spell
// (it asks again after an e-stop, which un-homes everything, or a daemon restart).
let homeAsked = false;
function offerHome() {
  const a = last.arm;
  if (!a || !a.homed) return;
  const needs = ["x", "y"].some(k => a.joints && k in a.joints && !a.homed.includes(k));
  if (!needs) { homeAsked = false; return; }
  if (homeAsked || last.estopped || a.moving || document.getElementById("modal").classList.contains("show")) return;
  homeAsked = true;
  ask(t("The arm is not homed (its position is lost at every start). Home now? X and Y seek their switches; Z returns to zero.")).then(ok => {
    if (ok) runHome();
  });
}
setInterval(offerHome, 1500);
document.getElementById("desktop").onclick = () => { toast(t("Exiting to desktop…"), "info"); post("/kiosk-exit"); };
document.getElementById("reboot").onclick = async () => { if (await ask(t("Reboot the Pi?"), true)) { toast(t("Rebooting…"), "warn", 8000); post("/reboot"); } };
document.getElementById("poweroff").onclick = async () => { if (await ask(t("Power OFF the Pi?"), true)) { toast(t("Powering off…"), "warn", 8000); post("/poweroff"); } };
tick(); setInterval(tick, 1500);

function showCoins(hdr) {
  let c = {coins: []}; try { c = JSON.parse(hdr) || c; } catch {}
  document.getElementById("coincount").textContent = c.coins.length || "";
  coinsNow = c.coins.filter(k => k.base).map(k => k.base);
  const box = document.getElementById("coins");
  if (!c.coins.length) { box.innerHTML = `<span class="idle">${t("no coins in view")}</span>`; return; }
  const away = c.at_survey === false ? `<div class="sub warn">${t("away from survey pose")}</div>` : "";
  box.innerHTML = c.coins.slice(0, 5).map((k, i) => {
    const p = k.base || k.cam, tag = k.base ? "" : " (cam)";
    const pos = p ? p.map(Math.round).join(", ") + " mm" + tag : t("no depth");
    return `<div class="coin"><span>#${i + 1} &empty;${2 * k.r}px</span><span>${pos}</span></div>`;
  }).join("") + away;
}

// Poll the annotated frame (works on WebKit/cog where MJPEG <img> doesn't).
let camUrl = null, camBusy = false;
async function pollCam() {
  if (camBusy || view3d || !last.camera || !last.camera.ok) return;
  camBusy = true;
  try {
    const r = await fetch("/detected?t=" + Date.now());
    if (r.ok) {
      showCoins(r.headers.get("X-Coins"));
      const url = URL.createObjectURL(await r.blob());
      const img = document.getElementById("cam");
      img.onload = img.onerror = () => { if (camUrl) URL.revokeObjectURL(camUrl); camUrl = url; };
      img.src = url;
    }
  } catch {} finally { camBusy = false; }
}
setInterval(pollCam, 250);   // ~4 fps

// ---- 3D view: the arm as flat-shaded plates on a plain 2D canvas (no WebGL, light on the Pi) ----
const GEOM = __GEOM__;                 // link lengths from domain/kinematics.py
let view3d = false, coinsNow = [];
const V = { az: -0.7, el: 0.5 };       // orbit angles (drag to turn)
const shown = { x: 0, y: 0, z: 0 };    // joints as drawn: eased toward the real ones
let animTimer = null, dragging = false, floorKey = "", floorCv = null;
const LIGHT = (() => { const l = [0.4, -0.5, 0.8], n = Math.hypot(l[0], l[1], l[2]); return l.map(v => v / n); })();
const C_PLATE = [122, 132, 145], C_ARM = [118, 146, 180], C_DARK = [30, 34, 40], C_BASE = [150, 160, 170],
      C_WHITE = [225, 230, 236], C_HUB = [92, 101, 113];

function viewVec() {                   // unit vector from the scene toward the viewer
  const ca = Math.cos(V.az), sa = Math.sin(V.az), ce = Math.cos(V.el), se = Math.sin(V.el);
  return [-ce * sa, -ce * ca, se];
}
function proj(P, w, h) {
  const ca = Math.cos(V.az), sa = Math.sin(V.az), ce = Math.cos(V.el), se = Math.sin(V.el);
  const x1 = P[0] * ca - P[1] * sa, y1 = P[0] * sa + P[1] * ca;
  const sc = Math.min(w, h) / 780;
  return [w / 2 + x1 * sc, h * 0.66 - (P[2] * ce + y1 * se - 120) * sc];
}
const dot = (a, b) => a[0] * b[0] + a[1] * b[1] + a[2] * b[2];

// A convex 2D outline (in the plane spanned by U and V, around O) extruded from w0 to w1 along W.
function extrude(out, poly, O, U, V3, W, w0, w1, col) {
  let area = 0;
  for (let i = 0; i < poly.length; i++) { const a = poly[i], b = poly[(i + 1) % poly.length]; area += a[0] * b[1] - b[0] * a[1]; }
  const sg = area < 0 ? -1 : 1;
  const at = (p, w) => [O[0] + U[0] * p[0] + V3[0] * p[1] + W[0] * w, O[1] + U[1] * p[0] + V3[1] * p[1] + W[1] * w,
                        O[2] + U[2] * p[0] + V3[2] * p[1] + W[2] * w];
  out.push({ pts: poly.map(p => at(p, w0)), n: W.map(v => -v), col: col });
  out.push({ pts: poly.map(p => at(p, w1)), n: W, col: col });
  for (let i = 0; i < poly.length; i++) {
    const a = poly[i], b = poly[(i + 1) % poly.length];
    let nx = (b[1] - a[1]) * sg, ny = -(b[0] - a[0]) * sg; const nl = Math.hypot(nx, ny) || 1;
    nx /= nl; ny /= nl;
    out.push({ pts: [at(a, w0), at(b, w0), at(b, w1), at(a, w1)],
               n: [U[0] * nx + V3[0] * ny, U[1] * nx + V3[1] * ny, U[2] * nx + V3[2] * ny], col: col });
  }
}
const rect = (r0, r1, h0, h1) => [[r0, h0], [r1, h0], [r1, h1], [r0, h1]];
function circle(c, r, n) { const p = []; for (let i = 0; i < n; i++) p.push([c[0] + r * Math.cos(i / n * 6.2832), c[1] + r * Math.sin(i / n * 6.2832)]); return p; }
function bar(A, B, wa, wb) {           // a tapered bar from A to B (width wa at A, wb at B)
  const dx = B[0] - A[0], dy = B[1] - A[1], l = Math.hypot(dx, dy) || 1, px = -dy / l, py = dx / l;
  return [[A[0] + px * wa, A[1] + py * wa], [B[0] + px * wb, B[1] + py * wb], [B[0] - px * wb, B[1] - py * wb], [A[0] - px * wa, A[1] - py * wa]];
}

function sceneFaces(j) {
  const rad = d => d * Math.PI / 180, ry = rad(j.y), rx = rad(j.x), rz = rad(j.z), cz = Math.cos(rz), sz = Math.sin(rz);
  const U = [cz, sz, 0], Vz = [0, 0, 1], W = [-sz, cz, 0], O = [0, 0, 0], faces = [];
  const S = [0, GEOM.D];
  const E = [S[0] + GEOM.L1 * Math.sin(ry), S[1] + GEOM.L1 * Math.cos(ry)];
  const Wr = [E[0] + GEOM.LF * Math.cos(rx), E[1] + GEOM.LF * Math.sin(rx)];
  const T = [Wr[0] + GEOM.LT, Wr[1]];                            // the levelling wrist keeps the tool horizontal
  const up = [-Math.sin(rx), Math.cos(rx)];                      // forearm "above" side
  const A = (p, o) => [p[0] + o[0], p[1] + o[1]];
  const k = (v, s) => [v[0] * s, v[1] * s];
  // fixed turntable (does not turn) and the turning disc
  extrude(faces, circle([0, 0], 100, 14), O, [1, 0, 0], [0, 1, 0], [0, 0, 1], 0, 22, C_BASE);
  extrude(faces, circle([0, 0], 78, 14), O, [1, 0, 0], [0, 1, 0], [0, 0, 1], 22, 44, C_HUB);
  // turning part: column, rear motor, shoulder hub, upper arm, elbow hub
  const part = (poly, a, b, col) => extrude(faces, poly, O, U, Vz, W, a, b, col);
  part([[-55, 44], [60, 44], [45, S[1] - 6], [-35, S[1] - 6]], -38, 38, C_PLATE);
  part(rect(-125, -50, 85, 150), 38, 84, C_DARK);                // stepper motor on the side
  part(circle(S, 32, 12), -50, 50, C_HUB);
  part(bar(S, E, 30, 20), -46, -38, C_ARM); part(bar(S, E, 30, 20), 38, 46, C_ARM);
  part(circle(E, 26, 12), -52, 52, C_HUB);
  // forearm: two plates plus a levelling rod above them, joined by short links
  const R = k(up, 70), Er = A(E, R), Wrr = A(Wr, R);
  part(bar(E, Wr, 24, 16), -40, -33, C_PLATE); part(bar(E, Wr, 24, 16), 33, 40, C_PLATE);
  part(bar(Er, Wrr, 6, 6), -42, -36, C_ARM); part(bar(Er, Wrr, 6, 6), 36, 42, C_ARM);
  part(bar(E, Er, 6, 6), -46, -40, C_ARM); part(bar(E, Er, 6, 6), 40, 46, C_ARM);
  part(bar(Wr, Wrr, 6, 6), -46, -40, C_ARM); part(bar(Wr, Wrr, 6, 6), 40, 46, C_ARM);
  part(circle(Wr, 20, 10), -48, 48, C_HUB);
  // tool: level arm, camera (white) and nozzle holder (black)
  part(rect(Wr[0], T[0] + 4, Wr[1] - 12, Wr[1] + 12), -22, 22, C_PLATE);
  part(rect(T[0] - 48, T[0] - 18, T[1] + 16, T[1] + 42), -46, 46, C_WHITE);
  part(rect(T[0] - 8, T[0] + 8, T[1], T[1] + 40), -9, 9, C_DARK);
  const at = r => [r[0] * cz, r[0] * sz, r[1]];
  return { faces: faces, tip: at(T) };
}

function ensureFloor(w, h) {            // rings and axes only change with the view: draw them once per view
  const key = [V.az.toFixed(3), V.el.toFixed(3), w, h].join();
  if (key === floorKey && floorCv) return floorCv;
  floorKey = key;
  floorCv = floorCv || document.createElement("canvas");
  floorCv.width = w; floorCv.height = h;
  const g = floorCv.getContext("2d");
  const line = (pts, col, wd) => {
    g.beginPath(); pts.forEach((P, i) => { const q = proj(P, w, h); i ? g.lineTo(q[0], q[1]) : g.moveTo(q[0], q[1]); });
    g.strokeStyle = col; g.lineWidth = wd; g.stroke();
  };
  for (let r = 100; r <= 400; r += 100) {
    const ring = []; for (let a = 0; a <= 40; a++) ring.push([r * Math.cos(a / 40 * 6.2832), r * Math.sin(a / 40 * 6.2832), 0]);
    line(ring, r === 400 ? "#30363d" : "#21262d", 1);
  }
  line([[-420, 0, 0], [420, 0, 0]], "#21262d", 1); line([[0, -420, 0], [0, 420, 0]], "#21262d", 1);
  line([[0, 0, 0], [120, 0, 0]], "#f85149", 2); line([[0, 0, 0], [0, 120, 0]], "#3fb950", 2);   // X red, Y green
  return floorCv;
}
function draw3d() {
  const cv = document.getElementById("v3d"), w = cv.clientWidth, h = cv.clientHeight;
  if (!w || !h) return;
  if (cv.width !== w) cv.width = w;
  if (cv.height !== h) cv.height = h;
  const g = cv.getContext("2d");
  g.clearRect(0, 0, w, h);
  g.drawImage(ensureFloor(w, h), 0, 0);
  g.lineJoin = "round";
  const vv = viewVec(), sc = Math.min(w, h) / 780;
  coinsNow.forEach(c => {                                        // detected coins on the table (base frame)
    g.beginPath();
    for (let a = 0; a < 10; a++) { const q = proj([c[0] + 11 * Math.cos(a / 10 * 6.2832), c[1] + 11 * Math.sin(a / 10 * 6.2832), 0], w, h); a ? g.lineTo(q[0], q[1]) : g.moveTo(q[0], q[1]); }
    g.closePath(); g.fillStyle = "#d29922"; g.fill();
  });
  const sc3 = sceneFaces(shown), tp = proj(sc3.tip, w, h), gr = proj([sc3.tip[0], sc3.tip[1], 0], w, h);
  g.beginPath(); g.arc(gr[0], gr[1], 4 * Math.max(1, sc * 1.4), 0, 6.2832); g.fillStyle = "#30363d"; g.fill();
  const vis = [];
  sc3.faces.forEach(f => {
    if (dot(f.n, vv) <= 0.001) return;                           // facing away
    let cx = 0, cy = 0, cz = 0;
    f.pts.forEach(p => { cx += p[0]; cy += p[1]; cz += p[2]; });
    f.d = dot([cx, cy, cz], vv) / f.pts.length; vis.push(f);
  });
  vis.sort((a, b) => a.d - b.d);                                 // far to near
  vis.forEach(f => {
    const sh = 0.45 + 0.55 * Math.max(0, dot(f.n, LIGHT));
    g.beginPath();
    f.pts.forEach((p, i) => { const q = proj(p, w, h); i ? g.lineTo(q[0], q[1]) : g.moveTo(q[0], q[1]); });
    g.closePath();
    g.fillStyle = "rgb(" + Math.round(f.col[0] * sh) + "," + Math.round(f.col[1] * sh) + "," + Math.round(f.col[2] * sh) + ")";
    g.fill(); g.strokeStyle = "rgba(0,0,0,.35)"; g.lineWidth = 1; g.stroke();
  });
  g.beginPath(); g.arc(tp[0], tp[1], 4, 0, 6.2832); g.fillStyle = "#f85149"; g.fill();   // tool tip
}
function animate3d() {
  animTimer = null;
  if (!view3d) return;
  const j = (last.arm && last.arm.joints) || {};
  let moving = dragging;
  ["x", "y", "z"].forEach(k => {
    const want = j[k] != null ? j[k] : shown[k], d = want - shown[k];
    if (Math.abs(d) > 0.05) { shown[k] += d * 0.35; moving = true; } else shown[k] = want;
  });
  draw3d();
  if (moving) animTimer = setTimeout(animate3d, 66);            // ~15 fps only while something changes
}
function kick3d() { if (view3d && !animTimer) animTimer = setTimeout(animate3d, 0); }

// While the 3D view is open follow the arm through /pose (joint angles only: no system metrics, no GPIO reads).
let poseBusy = false;
async function pollPose() {
  if (!view3d || poseBusy) return;
  poseBusy = true;
  try {
    const p = await (await fetch("/pose")).json();
    last.arm = last.arm || {}; last.arm.joints = p.joints; kick3d();
  } catch (e) {} finally { poseBusy = false; }
}
setInterval(pollPose, 300);

document.getElementById("bigstop").onclick = () => document.getElementById("estop").click();   // stop stays one tap away
document.getElementById("v3dbtn").onclick = () => {
  view3d = !view3d;
  document.getElementById("v3d").style.display = view3d ? "block" : "none";
  document.getElementById("camwrap").classList.toggle("big", view3d);       // full screen while the 3D view is open
  document.getElementById("cam").style.visibility = view3d ? "hidden" : "visible";
  document.getElementById("camoff").style.visibility = view3d ? "hidden" : "visible";
  document.getElementById("v3dbtn").textContent = view3d ? t("Camera") : "3D";
  kick3d();
};
(function () {                                                   // drag to orbit
  const cv = document.getElementById("v3d"); let px = null, py = null;
  const pos = e => { const t0 = (e.touches && e.touches[0]) || e; return [t0.clientX, t0.clientY]; };
  cv.addEventListener("pointerdown", e => { [px, py] = pos(e); dragging = true; });
  window.addEventListener("pointerup", () => { px = null; dragging = false; });
  window.addEventListener("pointermove", e => {
    if (px === null) return;
    const [x, y] = pos(e);
    V.az += (x - px) * 0.01; V.el = Math.max(0.05, Math.min(1.45, V.el + (y - py) * 0.01));
    px = x; py = y; kick3d();
  });
})();
</script></body></html>""".replace("__GEOM__", json.dumps({
    "L1": kinematics.UPPER_ARM_MM, "LF": kinematics.FOREARM_MM,
    "LT": kinematics.TOOL_REACH_MM, "D": kinematics.V_OFFSET_MM}))
