Quezka/moneysort/moneysort/hardware/camera.py

"""RealSense D435 owned by the daemon: one process holds the camera and serves
frames to everything else (like armd is the single GPIO owner).

A background thread continuously grabs aligned depth+colour frames and keeps the
latest under a lock. `jpeg()` returns the latest colour as JPEG (for the MJPEG
feed); `detect()` runs coin detection on the latest frame and returns the coins
(camera-frame 3D) plus an annotated JPEG.

All heavy imports are guarded: if pyrealsense2 / OpenCV aren't installed or no
device is present, the Camera comes up `ok=False` with an `error` message and the
daemon keeps running arm-only.
"""
import threading
import time

try:
    import numpy as np
    import cv2
    import pyrealsense2 as rs
    from moneysort import vision
    _LIBS = True
except ImportError as e:                 # noqa: F841 -- reported via Camera.error
    _LIBS = False
    _IMPORT_ERR = str(e)

# (depth w,h,fps), (colour w,h,fps). USB2 can't sustain colour 640@15 continuously
# (the colour stream stalls while depth keeps flowing), so use low fps -- the feed
# only polls a few fps anyway. USB3 first, then USB2-safe.
USB3 = [((640, 480, 30), (640, 480, 30))]
USB2 = [((480, 270, 6), (640, 480, 6)),
        ((480, 270, 6), (424, 240, 6)),
        ((480, 270, 15), (424, 240, 15))]

JPEG_Q = 70

# Colour tuning. Auto-WB is fine but needs time to settle -- a too-short warm-up
# locks it on a bad (often warm) value, and it re-does that on every reconnect.
# If auto still lands wrong for your lighting, set AUTO_WB=False and tune
# WHITE_BALANCE (Kelvin; lower = warmer correction).
AUTO_WB = True
WHITE_BALANCE = 4600
WARMUP_FRAMES = 30


class Camera:
    def __init__(self):
        self.ok = False
        self.error = None
        self.desc = None
        self._lock = threading.Lock()
        self._color = None
        self._depth = None
        self._intr = None
        self._depth_scale = 1.0
        self._pipe = None
        self._align = None
        self._run = True
        self._ref = None                     # reference frame for shift() (set by mark_ref)
        self._stab_lock = threading.Lock()
        self._stab_thumb = None              # tiny grey copy of the last detected frame
        self._stab_hist = []                 # coins detected in the last 2 calls (static scene)
        if not _LIBS:
            self._run = False
            self.error = f"camera libs missing ({_IMPORT_ERR})"
            return
        threading.Thread(target=self._supervise, daemon=True).start()

    def _supervise(self):
        """Keep the camera open and recover automatically from unplug/replug."""
        while self._run:
            try:
                self._open()                 # sets pipe/align/desc, or raises
                self.ok, self.error = True, None
                self._capture()              # runs until a persistent failure
            except Exception as e:
                self.error = f"camera unavailable: {e}"
            self.ok = False
            try:
                if self._pipe is not None:
                    self._pipe.stop()
            except RuntimeError:
                pass
            self._pipe = None
            with self._lock:
                self._color = self._depth = self._intr = None
            if self._run:
                time.sleep(2.0)              # let a re-plug settle, then retry

    def _open(self):
        ctx = rs.context()
        if len(ctx.query_devices()) == 0:
            raise RuntimeError("no RealSense device")
        dev = ctx.query_devices()[0]
        try:
            usb3 = dev.get_info(rs.camera_info.usb_type_descriptor).startswith("3")
        except RuntimeError:
            usb3 = False
        last = None
        for (dw, dh, dfps), (cw, ch, cfps) in (USB3 if usb3 else USB2):
            pipe = rs.pipeline()
            cfg = rs.config()
            cfg.enable_stream(rs.stream.depth, dw, dh, rs.format.z16, dfps)
            cfg.enable_stream(rs.stream.color, cw, ch, rs.format.bgr8, cfps)
            try:
                profile = pipe.start(cfg)
                self._tune_color(profile)
                for _ in range(WARMUP_FRAMES):       # let auto-exposure + WB settle
                    pipe.wait_for_frames(2000)
                self._pipe = pipe
                self._align = rs.align(rs.stream.color)
                self._depth_scale = profile.get_device().first_depth_sensor().get_depth_scale()
                self.desc = f"colour {cw}x{ch}@{cfps} ({'USB3' if usb3 else 'USB2'})"
                return
            except RuntimeError as e:
                last = e
                try:
                    pipe.stop()
                except RuntimeError:
                    pass
                time.sleep(0.5)
        raise RuntimeError(f"no stream config held ({last})")

    def _tune_color(self, profile):
        """Set colour white-balance/exposure so it's consistent across reconnects."""
        try:
            cs = profile.get_device().first_color_sensor()
            if cs.supports(rs.option.enable_auto_exposure):
                cs.set_option(rs.option.enable_auto_exposure, 1)
            if cs.supports(rs.option.enable_auto_white_balance):
                cs.set_option(rs.option.enable_auto_white_balance, 1 if AUTO_WB else 0)
            if not AUTO_WB and cs.supports(rs.option.white_balance):
                cs.set_option(rs.option.white_balance, float(WHITE_BALANCE))
        except Exception:
            pass

    def _capture(self):
        fails = 0
        while self._run:
            try:
                frames = self._align.process(self._pipe.wait_for_frames(2000))
                depth = frames.get_depth_frame()
                color = frames.get_color_frame()
                if not depth or not color:
                    continue
                # COPY into plain arrays -- holding pyrealsense frames/views starves
                # the frame pool and freezes the stream. intrinsics is a value copy.
                img = np.array(color.get_data())                 # BGR
                dep = np.array(depth.get_data())                 # uint16 HxW
                intr = depth.profile.as_video_stream_profile().intrinsics
                with self._lock:
                    self._color, self._depth, self._intr = img, dep, intr
                fails = 0
            except RuntimeError:
                fails += 1
                if fails > 5:               # persistent disconnect -> reopen device
                    raise
                time.sleep(0.1)

    def _encode(self, img):
        if img is None:
            return None
        ok, buf = cv2.imencode(".jpg", img, [cv2.IMWRITE_JPEG_QUALITY, JPEG_Q])
        return buf.tobytes() if ok else None

    def jpeg(self):
        """Latest colour frame as JPEG bytes, or None if not ready."""
        with self._lock:
            img = None if self._color is None else self._color.copy()
        return self._encode(img)

    def frame_size(self):
        """(width, height) of the latest colour frame, or None."""
        with self._lock:
            return None if self._color is None else (int(self._color.shape[1]), int(self._color.shape[0]))

    def _small_gray(self):
        with self._lock:
            if self._color is None:
                return None
            img = self._color
        g = cv2.cvtColor(img, cv2.COLOR_BGR2GRAY)
        return cv2.resize(g, (320, 240), interpolation=cv2.INTER_AREA).astype(np.float32)

    def mark_ref(self):
        """Remember the current frame as the reference for shift(). False if there is no frame."""
        g = self._small_gray()
        self._ref = g
        return g is not None

    def shift(self):
        """How far the whole picture moved since mark_ref(): {dx, dy, response} in full-res pixels.

        Phase correlation of the two frames: with the camera on the arm and a static table, every
        object moves by the same amount when the arm moves, so this tells where a coin went
        WITHOUT identifying it (in a pile, neighbouring coins look alike and tracking by nearest
        circle jumps to the wrong one). response ~1 = reliable, near 0 = no usable texture.
        """
        cur, ref = self._small_gray(), self._ref
        if cur is None or ref is None:
            return None
        win = cv2.createHanningWindow((320, 240), cv2.CV_32F)
        (dx, dy), resp = cv2.phaseCorrelate(ref, cur, win)
        return {"dx": float(dx) * 2.0, "dy": float(dy) * 2.0, "response": float(resp)}

    def detect(self, **params):
        """Detect coins on the latest frame -> (coins, annotated_jpeg)."""
        with self._lock:                              # grab copies, then work unlocked
            if self._color is None:
                return [], None
            img = self._color.copy()
            depth, intr, scale = self._depth, self._intr, self._depth_scale

        def depth_at(x, y, half=6):
            # Median of the valid readings in a small patch, not one pixel: the sensor has
            # holes (shiny metal, USB2's low-res depth) and a single 0 made a near coin yellow.
            if not (0 <= y < depth.shape[0] and 0 <= x < depth.shape[1]):
                return 0.0
            patch = depth[max(y - half, 0):y + half + 1, max(x - half, 0):x + half + 1]
            valid = patch[patch > 0]
            if valid.size < max(4, patch.size // 10):  # mostly holes: no trustworthy depth
                return 0.0
            return float(np.median(valid)) * scale    # z16 counts -> metres

        coins, annotated = vision.detect_coins(
            img, depth_at,
            lambda x, y, d: rs.rs2_deproject_pixel_to_point(intr, [x, y], d),
            **params)
        coins = self._hold_missed(coins, img, annotated, params.get("square", True))
        return coins, self._encode(annotated)

    def _hold_missed(self, coins, img, annotated, square):
        """Stop coins from flickering: Hough misses a coin in ~1 frame of 6 on a pile.

        While the scene is static (a tiny thumbnail of the frame barely changes between calls), a
        coin that was seen in either of the previous two calls and is missing now is kept
        (drawn orange, `held: True`). If the camera moved or the scene changed, nothing is held.
        """
        thumb = cv2.resize(cv2.cvtColor(img, cv2.COLOR_BGR2GRAY), (80, 60), interpolation=cv2.INTER_AREA)
        with self._stab_lock:
            prev = self._stab_thumb
            static = prev is not None and float(np.mean(cv2.absdiff(thumb, prev))) < 2.5
            hist = self._stab_hist if static else []
            seen = [c for c in coins]                      # what was really detected this time
            H, W = img.shape[:2]
            ox = (W - min(H, W)) // 2 if (square and W != H) else 0
            oy = (H - min(H, W)) // 2 if (square and W != H) else 0
            held = []
            for old in (c for frame in hist for c in frame):
                if any((old["px"] - c["px"]) ** 2 + (old["py"] - c["py"]) ** 2 < (0.5 * min(old["r"], c["r"])) ** 2
                       for c in seen + held):
                    continue
                keep = dict(old, held=True)
                held.append(keep)
                cv2.circle(annotated, (old["px"] - ox, old["py"] - oy), old["r"], (0, 165, 255), 2)
            self._stab_thumb = thumb
            self._stab_hist = (hist + [seen])[-2:]
        return coins + held

    def close(self):
        self._run = False
        if self._pipe is not None:
            try:
                self._pipe.stop()
            except RuntimeError:
                pass
