Quezka/moneysort/moneysort/vision.py

"""Coin detection on a colour frame -- OpenCV only, no RealSense import.

Given a BGR image plus callables to look up depth and deproject a pixel to a 3D
point, find coin-like circles (Hough), keep those whose centre depth is in range
(this rejects the background), and return each with its pixel + camera-frame 3D
point (mm). Kept hardware-free (the caller supplies depth_at / deproject) so the
detection logic can be exercised with a plain image + stub callables.
"""
import cv2
import numpy as np

DEFAULTS = dict(min_r=18, max_r=45, min_dist=22, param2=26, min_z=0.20, max_z=0.60,
                require_depth=True, highlight=None)   # highlight=(px, py): mark the coin there


def _find_circles(img, p):
    """Hough circles on brightness AND on colour saturation, merged.

    Coins differ in colour: a silver one next to gold ones has almost no brightness edge, but
    stands out in saturation (and vice versa). Running both and merging finds all of them. Coins
    in a pile overlap, so min_dist is small; max_r drops the big false circles on cardboard.
    """
    chans = (cv2.cvtColor(img, cv2.COLOR_BGR2GRAY), cv2.cvtColor(img, cv2.COLOR_BGR2HSV)[:, :, 1])
    found = []
    for ch in chans:
        c = cv2.HoughCircles(cv2.medianBlur(ch, 5), cv2.HOUGH_GRADIENT, dp=1.2, minDist=p["min_dist"],
                             param1=100, param2=p["param2"], minRadius=p["min_r"], maxRadius=p["max_r"])
        if c is None:
            continue
        for x, y, r in c[0]:
            if all((x - fx) ** 2 + (y - fy) ** 2 > (0.4 * min(r, fr)) ** 2 for fx, fy, fr in found):
                found.append((x, y, r))
    return np.array([found], dtype=np.float32) if found else None


def detect_coins(bgr, depth_at, deproject, *, square=True, **params):
    """Detect coins. Returns (coins, annotated_bgr).

    depth_at(px, py) -> metres (0 = none); deproject(px, py, d) -> (x,y,z) metres.
    coins: list of {px, py, r, depth_ok, depth_m, cam_mm=[x,y,z]} in FULL-frame pixels.

    The D435 can't read depth much closer than min_z. With require_depth=False a
    circle whose depth is missing/out of range is still returned, with
    depth_ok=False, depth_m=0 and cam_mm=None: enough to centre it in the image. depth_raw is
    what the sensor read there (0 = no reading), so yellow can be told apart: out of range vs a hole.
    """
    p = {**DEFAULTS, **params}
    H, W = bgr.shape[:2]
    if square and W != H:                       # centre-square crop, drop clutter
        s = min(H, W)
        ox, oy = (W - s) // 2, (H - s) // 2
        img = bgr[oy:oy + s, ox:ox + s]
    else:
        ox = oy = 0
        img = bgr

    circles = _find_circles(img, p)

    out = img.copy()
    coins = []
    if circles is not None:
        for cx, cy, r in np.round(circles[0]).astype(int):
            fx, fy = int(cx + ox), int(cy + oy)         # full-frame pixel
            d = depth_at(fx, fy)
            if not d or not (p["min_z"] <= d <= p["max_z"]):
                if not p["require_depth"]:
                    coins.append({"px": fx, "py": fy, "r": int(r), "depth_ok": False,
                                  "depth_m": 0.0, "depth_raw": float(d or 0.0), "cam_mm": None})
                    cv2.circle(out, (cx, cy), r, (0, 220, 255), 2)      # yellow = no depth
                    cv2.putText(out, f"{d:.2f}m" if d else "hole", (cx - r, cy - r - 4),   # why: out of range or no reading
                                cv2.FONT_HERSHEY_SIMPLEX, 0.5, (0, 220, 255), 1)
                    cv2.circle(out, (cx, cy), 2, (0, 0, 255), 3)
                else:
                    cv2.circle(out, (cx, cy), r, (60, 60, 60), 1)       # grey = rejected
                continue
            x, y, z = deproject(fx, fy, d)
            coins.append({"px": fx, "py": fy, "r": int(r), "depth_ok": True, "depth_m": float(d),
                          "cam_mm": [x * 1000.0, y * 1000.0, z * 1000.0]})
            cv2.circle(out, (cx, cy), r, (0, 255, 0), 2)
            cv2.circle(out, (cx, cy), 2, (0, 0, 255), 3)
            cv2.putText(out, f"{d:.2f}m", (cx - r, cy - r - 4),
                        cv2.FONT_HERSHEY_SIMPLEX, 0.5, (0, 255, 0), 1)
    hl = p["highlight"]
    if hl and coins:                                    # the coin we are locked on: magenta ring
        c = min(coins, key=lambda k: (k["px"] - hl[0]) ** 2 + (k["py"] - hl[1]) ** 2)
        if (c["px"] - hl[0]) ** 2 + (c["py"] - hl[1]) ** 2 <= 60 ** 2:
            cx, cy = c["px"] - ox, c["py"] - oy
            cv2.circle(out, (cx, cy), c["r"] + 8, (255, 0, 255), 3)
            cv2.putText(out, "TARGET", (cx - 30, cy + c["r"] + 26),
                        cv2.FONT_HERSHEY_SIMPLEX, 0.6, (255, 0, 255), 2)
    return coins, out
