Quezka/moneysort/(commit log)

2026-07-27 Add Motor 1 first-pulse test script
2026-07-27 Direct 3.3V common-cathode test; add project TODO
2026-07-27 Add speed (pps) arg + accel ramp to motor test
2026-07-27 Add lgpio Stepper class with trapezoidal accel; rewrite test to use it
2026-07-27 Fix Stepper.close(): tx_pulse(0,0) rejects zero micros; park pin low instead
    [stepper.py]
2026-07-27 Add Arm multi-axis controller, status dashboard, and kiosk launcher
2026-07-27 Rename joints to X/Y/Z, add shared ENA on GPIO22, per-axis jog test
2026-07-27 Add live arm state.json feed to dashboard; show last-known angles + freshness
2026-07-27 Move shared enable pin to GPIO26 (pin 37)
2026-07-27 Relabel axes: base=Z, shoulder=Y, elbow=X (swap X/Z labels, pins stay)
    [arm.py]
2026-07-27 Update disable() docstring: shared 3.3V disable verified working
2026-07-27 Add dashboard controls: emergency motor disable/enable + reboot/poweroff
    [dashboard.py]
2026-07-27 Add armd arm daemon with latched e-stop; arm_test becomes HTTP client; deploy service
2026-07-27 Fix port clash (kiosk no longer starts its own server); add Desktop exit button + relaunch icon
    [armd.py, dashboard.py]
2026-07-27 Add coordinated multi-axis motion (Arm.move_many, /move moves dict); default 20000 pps
2026-07-27 Per-axis config with calibration (z=150k steps/rev, y travel 33k); document it
2026-07-27 Correct z calibration: 90deg=40500 steps -> 162000 steps/rev
    [arm.py]
2026-07-27 Add repo deploy.sh (git pull + restart moneysort-arm)
2026-07-27 Add zero-position button/endpoint (Arm.zero) to set current pose as home
2026-07-27 Record planned home switch pins (y=GPIO8 neg, x=GPIO7 pos); document. Switches not wired yet
2026-07-27 Implement Y homing: find_home routine, /find_home, Home Y button, switch in status
2026-07-27 Fast two-stage homing: home_seek ramps+cruises+halts on switch, then slow re-approach
2026-07-27 Y: calibrate 132000 steps/rev (90deg=33k) + homed-aware soft limits 0..33000
2026-07-29 Changed Homing
2026-07-30 X: wire home switch (home_dir=+1 verified), soft-limit -33000..0
    Both X and Y home switches now wired and homing works. X homes toward
    +steps to zero at the positive end; usable range clamps to -33000..0
    once homed. Docs updated.
2026-07-30 Firm homing seat (debounced) + emergency-disable aborts motion
    find_home now advances the fine approach until the switch reads stably
    triggered (n consecutive reads), so an axis resting on the trigger edge
    (x) seats solidly like one with margin (y) instead of flickering.
    Shared abort Event: Arm.disable() sets it (and un-homes every axis, since
    positions are unknown after an abrupt stop), enable() clears it. move,
    move_many, jog, home_seek and find_home all check it and truncate their
    pulse train, so the dashboard EMERGENCY DISABLE stops the task in flight,
    not just the torque.
2026-07-30 Chunk cruise so emergency disable actually stops a move in flight
    lgpio plays a finite burst to the end; only an infinite burst can be cut
    short (which is why home_seek's halt works but a normal move ignored the
    e-stop for its full duration). Split the cruise into ~40ms bursts: on
    abort the feed loop stops queuing and the few already-queued bursts drain
    in well under a second. Dropped the ineffective _halt() on finite trains.
    [arm.py, stepper.py]
2026-07-30 Dashboard: single Home button; z returns to zero on home
    Replace the "Home Y" button with one "Home" that posts /home. home_all
    now homes each axis appropriately: x and y seek their switches
    (find_home), while the switch-less z drives back to its zero position
    (no-op if already there).
    [arm.py, armd.py, dashboard.py]
2026-07-30 Dashboard: Return-to-zero button; move switch-homing into Settings
    Return to zero is the everyday move -- drive every axis back to its
    tracked zero (no switch seek) via /return_zero. Switch homing is an
    init/calibration step, so the Home button now lives in a collapsible
    Settings section. Also relabel "Zero position" -> "Set zero here" to
    distinguish setting the reference from driving to it.
2026-07-30 Dashboard: themed toast notifications for arm actions
    Slide-in toasts (info/success/warn/error) report the outcome of each
    control: "Already at zero" when return-to-zero is a no-op, "Returning to
    zero…/Back at zero", homing progress, zero set, e-stop, re-enable, and
    errors (no connection / disabled). post() now returns the parsed response
    so success vs failure and mid-action e-stop are reflected honestly.
    [dashboard.py]
2026-07-30 Dashboard: make toasts bigger and more visible
    Top-center, larger (21px bold), tinted per-type background, stronger
    shadow, springy slide-down entrance, and a slightly longer default TTL.
2026-07-30 X: calibrate steps_per_rev=132000 (33k steps = 90deg, range 0..-90)
    Home at 0 (positive end), physical max at -33000 steps = -90 deg. Same
    scale as y. Fixes X angle display and makes move_degrees("x") accurate.
    [arm.py]
2026-09-19 docs: CLI usage — arm_test.py and curl HTTP API
    Document commanding the arm from a terminal: arm_test.py (on the Pi) for
    move/home, and the full curl HTTP API (from any PC) incl. move, find_home,
    home, return_zero, zero, disable/enable, status. Adds steps<->degrees
    conversions per axis.
2026-09-19 Add CLAUDE.md: portable project context
    Distill the durable project state into the repo so any Claude Code session
    on any machine picks it up via git (no local ~/.claude memory needed):
    workflow rule, architecture, hardware summary, per-axis calibration/limits,
    status and next steps, with pointers to docs/PINOUT.md and docs/USAGE.md.
2026-09-19 Restructure into a layered moneysort/ package
    Dependencies point inward (interface -> app -> hardware -> domain; config
    shared innermost), so the domain is pure and unit-testable off-hardware.
    - domain/: planning.py (pure trapezoid, extracted from Stepper),
    kinematics.py (FK/IK stub), config.py (single source: pins/calibration).
    - hardware/stepper.py: lgpio STEP/DIR executor, consumes domain.planning.
    - app/: arm.py (Arm) + controller.py (ArmController, split out of armd).
    - interface/: server.py (daemon+HTTP), dashboard.py (PAGE + metrics only),
    cli.py (arm_test logic).
    - armd.py / arm_test.py at root are now thin shims into the package, so the
    systemd unit and documented CLI paths a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
2026-09-20 docs: add ARCHITECTURE.md (layers, modules, runtime, mechanisms)
    Describes the layered moneysort/ package (interface->app->hardware->domain),
    every module, the HTTP API, the request lifecycle, and the key mechanisms:
    trapezoidal planning + cruise chunking, latched e-stop/abort, coordinated
    multi-axis, two-stage homing + soft limits, deploy/runtime model. Linked
    from CLAUDE.md.
2026-09-20 Homing: debounce the fast-approach switch check (no premature slow crawl)
    The fine approach already debounces (_stable_home), but the fast approach's
    stop condition and the "already home?" guard used a single raw at_home()
    read. During fast stepping a lone sample can blip HIGH from pulse
    noise/vibration, ending (or skipping) the fast phase so most of the travel
    crawls at slow_pps -- very slow from full extension. Use a 3-sample
    debounced check there too; it returns on the first LOW read while the switch
    is open, so it adds no cost during the approach.
    [arm.py]
2026-09-20 Implement kinematics: FK + IK from measured geometry
    Measured: upper arm 220mm, forearm 310mm, shoulder pivot 120mm up.
    Model: base yaw z; upper arm angle y from vertical (0=up..90=horizontal);
    forearm absolute angle phi = y + 90 - x (elbow relative bend 90-x). Home
    (y0,x0) = "r" shape, tool at (r310,h340); (y0,x-90) folds straight down.
    forward() -> tool Point in base frame; inverse() -> JointAngles (2-link
    planar IK in the yaw plane, home elbow branch), raising OutOfReach beyond
    links or joint limits. 8 unit tests incl. full FK<->IK round-trip, all pure.
    Elbow modelled as a RELATIVE joint (forearm carries with the upper arm);
    verify on hardware by moving y with x held and watching the fo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
2026-09-20 docs: kinematics implemented (pending on-arm validation)
    Update CLAUDE.md + ARCHITECTURE.md from "stub" to the implemented FK/IK, and
    record the validation protocol still to run on the real arm.
2026-09-20 Kinematics: elbow is ABSOLUTE (phi = 90 - x), verified on hardware
    On-arm test: moving the shoulder with the elbow held kept the forearm
    horizontal in space (translated forward + down, did not tilt) -- so the
    forearm holds an absolute orientation, not a bend relative to the upper arm.
    forward() uses phi = 90 - x; inverse() maps x = 90 - (alpha + delta). Tests
    updated, FK<->IK round-trip still green.
2026-09-20 Kinematics: fit geometry to on-arm measurements (tool tip)
    Tape lengths didn't match the real pivot-to-pivot kinematics (joint offsets +
    tool tip past the last pivot). Least-squares over on-arm tip measurements
    (home + shoulder-swung pose) gives effective upper arm 140mm, forearm-to-tip
    355mm, base height 185mm (residuals <=4mm). Forearm-to-last-pivot ~305mm
    (~= tape 31cm); the tip is ~50mm beyond. Tests made length-agnostic (compute
    expected from the constants). UPPER_ARM still rests on one pose -- to refine.
    [test_kinematics.py]
2026-09-20 Kinematics: refine geometry over 3 shoulder poses (0..87 deg)
    Added a near-horizontal pose (y~87, r=51/h=18.7cm); least-squares over all
    three tip poses -> upper 149mm, forearm-to-tip 356mm, base 177mm (residuals
    <=6mm). Upper-arm length now anchored across the shoulder range, not one pose.
2026-09-20 Wire move_to(point): IK -> coordinated joint move
    Arm.move_to(point) solves inverse kinematics, converts each joint angle to an
    absolute step target, and drives all axes together via move_many. Requires x/y
    homed (position must map to real angles); raises OutOfReach if unreachable.
    Exposed as ArmController.move_to, POST /move_to {x,y,z[,pps]} (mm, base frame),
    and `arm_test.py moveto X Y Z [pps]`.
2026-09-21 Kinematics: levelling-wrist model fit to 3x3 grid (rms ~1cm)
    The elbow drives a linkage with a levelling wrist -- the forearm tilts but a
    passive pivot keeps the tool level, so the tool adds a CONSTANT horizontal
    reach instead of rotating with the forearm. Simple 2-link trig couldn't fit
    (off ~5cm). New model, fit to a 9-pose on-arm tip grid:
    r = L1 sin(y) + LF cos(x) + LT ; h = L1 cos(y) + LF sin(x) + D
    (L1 161, LF 210, LT 132, D 168 mm; Z from base plate) -> rms 1.0cm, max 2.0cm.
    forward()/inverse() rewritten (closed-form inverse, branch within limits).
    Tests: FK<->IK round-trip + grid-accuracy check. CLAUDE.md updated.
2026-09-21 Camera: pyrealsense2 install script + D435 smoke test
    deploy/install_realsense.sh: tries a pip wheel, else builds librealsense from
    source with the Python bindings for system python3 (FORCE_RSUSB_BACKEND, no
    kernel patching), installs udev rules, copies pyrealsense2*.so onto the path.
    tools/realsense_test.py: opens the D435, streams aligned depth+colour, prints
    centre-pixel depth and the deprojected 3D point (the pixel->3D primitive).
    [realsense_test.py]
2026-09-21 realsense_test: USB2 fallback + USB-type report + graceful stop
    Try full 640x480@30 first, then fall back to lower-bandwidth configs so it
    streams over USB2 (D435 can't do depth+colour both at 640@30 on USB2). Print
    the negotiated USB type, and guard pipe.stop() so a failed start doesn't throw.
    [realsense_test.py]
2026-09-21 realsense_test: pick config by USB type, validate by pulling frames
    start() succeeds on USB2 even for 640@30 then dies at wait_for_frames and
    knocks the camera off the bus, so the old fallback never triggered. Now choose
    the config from the negotiated USB type up front (never attempt 640@30 on USB2)
    and validate each candidate by actually streaming ~10 frames before accepting.
2026-09-21 Vision: coin_detect.py -- find coins + locate them in 3D (camera frame)
    Grabs one aligned depth+colour frame, HoughCircles on the colour image, reads
    each centre's depth and deprojects to a 3D camera-frame point, saves an
    annotated PNG + raw colour + depth colormap (headless), prints each coin.
    Detection params tunable via flags. Needs python3-opencv.
2026-09-22 coin_detect: 720p capture, depth gate, centre-square crop, tuned radii
    - Capture colour at 1280x720@6 (USB2-ok single shot) for ~3x detail; depth
    low-res, aligned/upsampled to colour.
    - DEPTH GATE: keep only circles whose centre depth is in [min-z,max-z] (default
    0.2-0.6m). Kills the background false positives (no-depth / out of range).
    - Centre-square crop (--no-square to disable) drops cluttered edges; pixels
    mapped back to the full frame for depth + deprojection.
    - Radii/min-dist defaults retuned for 720p; longer warm-up for exposure/WB.
2026-09-22 Camera: calibrate_camera.py -- camera->base transform at a survey pose
    Eye-in-hand calibration by correspondence: at a fixed survey pose, detect a
    coin -> p_cam (camera frame), jog the tool to touch it -> p_base (FK from
    armd joint angles). Collect >=4 spread points, solve rigid transform
    base_mm = R@cam_mm + t (Kabsch/SVD), save camera_calib.json with the survey
    pose + residual. Re-run if the mount shifts.
    [calibrate_camera.py]
2026-09-22 calibrate_camera: auto-return to survey pose between points
    Record the survey pose once at start, then drive all axes back to it before
    each capture (via armd /move) so every p_cam is taken from the exact same
    pose -- hand-jogging back precisely was error-prone. Reuses config steps/rev.
    [calibrate_camera.py]
2026-09-22 Camera: armd owns the RealSense; live MJPEG feed on the dashboard + /detect
    armd becomes the single camera owner (like it owns the GPIO):
    - hardware/camera.py: Camera runs a background capture thread holding the
    latest aligned depth+colour; jpeg() for the feed, detect() -> coins+3D.
    All heavy imports guarded -> daemon runs arm-only if libs/device missing.
    - vision.py: OpenCV coin detection (Hough + depth gate), hardware-free.
    - server.py: GET /camera (MJPEG stream), GET /snapshot, POST /detect; camera
    status in /status; construct + close the Camera in main().
    - dashboard.py: live camera tile (<img src=/camera>) with offline fallback.
    Needs python3-opencv + pyrealsense2 in the SYSTEM p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
    [camera.py, dashboard.py, server.py, vision.py]
2026-09-22 Route camera tools through armd; add /detected annotated frame
    armd owns the camera now, so the standalone tools can't open it. Rewire both
    to talk to armd over HTTP:
    - calibrate_camera.py: gets p_cam from POST /detect (no direct RealSense);
    keeps survey auto-return + touch->FK->p_base + Kabsch solve.
    - coin_detect.py: thin client -- POST /detect (print coins), GET /detected
    (save annotated frame).
    - server.py: add GET /detected returning the annotated detection JPEG.
2026-09-22 Camera/daemon: prompt shutdown + retry camera init (fix feed on redeploy)
    On redeploy the old daemon held the camera while it died slowly, so the new
    one failed to open it ("cannot access depth sensor") -> frozen feed. Fixes:
    - Shut down promptly: the SIGTERM handler called srv.shutdown() from the same
    thread as serve_forever() (deadlock -> 90s SIGKILL). Now it closes the camera
    and calls shutdown() from another thread; daemon_threads=True so MJPEG streams
    don't block exit. Releases the device fast.
    - Camera init retries for ~8s if the device is briefly busy (restart race).
    [camera.py, server.py]
2026-09-22 Dashboard: annotated feed, smaller cam tile, kiosk auto-reload on deploy
    - Feed shows the detection output: MJPEG /camera?detect=1 draws coins (~5fps);
    dashboard points at it.
    - Cap the camera tile at 300px so it no longer pushes the controls off-screen.
    - /status carries a BUILD id (daemon start time); the page reloads itself when
    it changes, so a deploy auto-refreshes the Pi's kiosk (no manual F5 needed
    after the first load).
    [dashboard.py, server.py]
2026-09-22 Dashboard: two-column layout (feed left, controls right) + no-cache
    - Put the camera feed and the controls side by side (controls stacked in a
    right column) so everything fits the Pi's 1280x800 panel without the feed
    pushing controls off-screen.
    - Serve responses with Cache-Control: no-store so a kiosk reload always gets
    the fresh page (works with the build-id auto-reload).
2026-09-22 Dashboard compact layout + camera self-heal (auto-reconnect)
    - Camera: a supervisor thread reopens the device automatically after an
    unplug/replug or a persistent capture failure -- no armd restart needed
    (the D435's USB-C keeps shaking loose on the taped mount).
    - Dashboard fits the 1280x800 panel: system stats in one compact row, smaller
    cards/joints/sections, camera tile 260px, and a NARROW 220px controls column
    beside the feed with tighter buttons -- so Settings no longer gets clipped.
    [camera.py, dashboard.py]
2026-09-22 Dashboard: poll frames (WebKit/cog-safe), bigger feed, controls to right edge
    - Feed: replace the MJPEG <img> stream with JS polling of /detected (~4fps).
    WebKit (what cog uses) doesn't reliably render multipart/x-mixed-replace in
    <img>, so the feed appeared frozen -- polling works everywhere.
    - Bump the camera tile to 340px and push the controls column to the right edge
    (margin-left:auto) for a bit more presence, still fits the panel.
    - kiosk.sh prefers cog (WPE WebKit, lightweight) over Chromium; exit_kiosk
    kills cog too.
    [dashboard.py]
2026-09-22 Camera: copy frames (fix frozen image); depth via array + scale
    The capture loop stored a numpy VIEW of the colour frame and held the depth
    FRAME reference, which starves the pyrealsense frame pool -> the stream freezes
    (the detection overlay kept redrawing on the same static frame). Now copy both
    into plain arrays, hold no frame refs, and read depth by index * depth_scale
    (deproject uses the intrinsics value copy). Detection runs outside the lock.
    [camera.py]
2026-09-22 Camera: fix frozen colour on USB2 (low fps) + WB warm-up/tune
    Raw snapshots proved the COLOUR stream freezes on USB2 at 640@15 while depth
    keeps flowing (bandwidth starvation -> wait_for_frames returns the last colour).
    Drop USB2 to colour 640x480@6 (keeps res for detection, ~half the data rate).
    Also: 30-frame warm-up + explicit auto-exposure/auto-WB (short warm-up was
    locking a bad white balance each reconnect); AUTO_WB/WHITE_BALANCE tunable if
    auto still lands wrong.
    [camera.py]
2026-09-22 Kiosk: fullscreen cog via COG_PLATFORM_WL_VIEW_FULLSCREEN env var
    The cog wl platform has no CLI/-O fullscreen switch, but its plugin
    reads COG_PLATFORM_WL_VIEW_FULLSCREEN (verified in libcogplatform-wl.so)
    and then requests xdg_toplevel.set_fullscreen from the compositor. This
    is cog-native and needs no labwc window rule, so back out the rc.xml
    rule from setup.sh (a labwc ToggleFullscreen on top of cog's own
    fullscreen request would just cancel it out).
2026-09-23 Base (z): hard-limit yaw to +/-180 deg from zero
    z has no home switch, so give it a symmetric hard limit around its
    power-on/zeroed position: config 'limit_deg' -> +/-78502 steps, always
    enforced (switch-less axes don't gate their limit on homing, unlike
    x/y which need the switch for a reference). Also add Z_MIN/Z_MAX to
    kinematics and reject IK targets whose base yaw exceeds them. x/y ranges
    unchanged (already enforced by IK + soft stops).
2026-09-23 tools/jog.py: interactive keyboard teleop over SSH
    Drives armd's HTTP API (never GPIO) so all armd guards apply -- x/y soft
    limits, base +/-180 hard limit, latched e-stop. JOINT mode jogs an axis
    in degrees (q/a/w/s/e/d); CARTESIAN mode jogs the tool tip in mm via
    move_to (arrows + w/s). h homes, k returns to zero, SPACE e-stops, Q
    quits. Live status shows joints, tip (X/Y/Z + reach), homed and e-stop
    state. Also expose 'homed'/'home' in GET /status for the tool to read.
2026-09-23 tools/jog.py: add repo-root sys.path bootstrap (fix ModuleNotFoundError)
    Run from tools/ put only tools/ on sys.path, not the repo root, so
    'import moneysort' failed. Match the bootstrap used by calibrate_camera.py.
    [jog.py]
2026-10-13 Docs: bring CLAUDE.md and ARCHITECTURE.md up to date (camera, vision, tools)
2026-10-13 Detections in base frame: domain/calibration + base_mm in /detect
2026-10-13 Real-time hold-to-move jog (POST /jog dead-man) + richer dashboard
    - armd: /jog target velocity with 0.25 s dead-man; jog thread feeds 40 ms step
    slices (Stepper.queue_slice, Arm.jog_slice); joint (deg/s) or cartesian (mm/s
    via the FK Jacobian); domain/jog.py + tests
    - tools/jog.py: hold-to-move client; read the raw fd so arrow keys no longer
    quit it (stdin buffering made them look like a lone Esc)
    - dashboard: tool position, axes homed, detected coins (X-Coins header from
    /detected), calibration badge; Italian strings added
2026-10-13 Docs: gripper research (suction cup for coins)
2026-10-13 Cartesian jog relative to the arm heading (sideways always swings the base)
    POST /jog accepts frame=arm: (radial, tangential, up) rotated by the base yaw
    before the Jacobian solve. jog.py uses it, so left/right is base-only at any yaw.
2026-10-13 Limit shoulder to 80 deg, slower return-to-zero, jog no longer freezes at singular poses
    - config.SHOULDER_MAX_DEG=80 (shoulder stalls fully extended); y travel and the
    kinematics Y_MAX follow it
    - RETURN_ZERO_PPS=6000 default for return_zero (was 20000)
    - cart jog: damped least squares instead of refusing near singularities, so the
    arm can always be jogged back out of an extreme pose
2026-10-13 armd logging + diagnostics, in-page dialogs, coin centering script
    - logging to journald: every POST (except /jog,/detect heartbeats), move
    start/end/duration, lock waits, jog start/end/crash, limit hits, e-stop/enable
    - /status arm.debug (lock_held, jog_alive, abort, positions, last_error) and the
    dashboard shows the last failure under the joints
    - limits: a position already beyond a limit only allows inward moves (no snap-back)
    - dashboard: in-page confirm dialog instead of window.confirm (kiosk shows none);
    coins without depth shown as 'no depth'
    - vision: require_depth=False keeps circles closer than the depth range
    - tools/center_coin.py + domain/centering.py: centre a coin by pix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
2026-10-13 Fix stuck TX queue: homing stop could fail with 'TX queue full' and leave an infinite pulse train running
    - Stepper._tx: single place that queues pulses, waits for room, retries a full
    queue, raises a readable error if it stays stuck (no silent hang)
    - home_seek: finally always ends the infinite cruise burst (halt waits for room)
    - Stepper.halt / Arm.disable: e-stop ends any running pulse train on every axis
    - every drain/wait on the queue is bounded; status shows tx_busy and the dashboard
    warns when pulses are still running while idle
    - tests against a fake lgpio reproduce the incident (old code: raises and leaves
    the train running)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
2026-10-13 Dashboard offers to home by itself when the arm is not homed (every start, after an e-stop)
2026-10-13 Dashboard: show running version and an input-event trace (kiosk touch diagnosis)
2026-10-13 Dashboard: drop the input-event trace line (kiosk tap fixed), keep the version label
2026-10-13 Docs: gripper shopping notes (RS Italia cups, AliExpress/Alibaba kits)
2026-10-14 Docs: keep the Amazon pump candidate (screenshot + notes)
2026-10-14 find_home: bound the slow approach so a flaky switch can't make the motor push into the stop forever
2026-10-14 Homing tolerates a chattering switch: pressed = >=2 HIGH reads in a window, not consecutive
2026-10-14 Stepper: hard-cancel a wedged tx queue (tx_pulse 0,0) so an axis recovers without restarting armd
2026-10-14 Camera: coin depth = median of a small patch (single-pixel holes made near coins yellow); e-stop hard-cancels busy axes
2026-10-14 center_coin: probes/steps that are out of reach try the other way or a smaller step; Jacobian uses the real displacement
2026-10-15 center_coin: wider working pose (50 mm of room): at the rest height the reachable radial band is only ~55 mm wide
2026-10-15 center_coin: when a step is out of reach, sink the tool (up to 50 mm) instead of giving up
2026-10-15 center_coin: faster and smoother (Jacobian learned once, gain 0.9, 35 mm steps, 0.35 s settle) + pile handling (nearest-to-centre first, then track the same coin by prediction)
2026-10-15 center_coin: pick the coin closest to the camera (top of the pile) by depth, nearest-to-centre among equals
2026-10-15 center_coin: continuous servo via /jog (smooth, no stop-and-go), sinks when out of reach; descend toward the coin by depth after confirming
2026-10-15 Recovery from a wedged lgpio queue: auto-restart armd (cancel first), POST /recover + dashboard button; center_coin back to 6000 pps
2026-10-15 center_coin: back to step moves (camera too slow for the continuous servo); servo kept behind SERVO=True
2026-10-15 center_coin: lock on the chosen coin (never switch), magenta TARGET ring on the dashboard preview via POST /target; fix descent ('no depth': the tracked coin was never passed to approach)
2026-10-15 Recovery keeps motors enabled (no e-stop); script retries a move after the auto-recovery; tx_busy errors no longer read as busy; log raw tx_room/tx_busy when stuck
2026-10-15 center_coin: descent is one smooth coordinated move to the lowest reachable Z (computed on the kinematics) instead of 10 mm steps
2026-10-15 Wedged queue: an idle axis with no free slot counts as stuck (restart), log raw tx_room/tx_busy; script heals on the return-home and first moves too
2026-10-15 Vision: merge channel duplicates more gently (0.4 r) so the overlapping silver coin in a pile is kept; verified 4/4 on two real frames
2026-10-15 Camera: hold a coin that flickers out of detection for 2 calls while the scene is static (orange ring); preview stream at ~2.5 fps to cut CPU
2026-10-15 Follow the coin by the whole picture's shift (phase correlation, POST /ref + /shift) instead of nearest circle: in a pile neighbours look alike and the Jacobian probes/tracking jumped to the wrong co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
2026-10-16 center_coin: calibration integrated (--calibra: camera->base at the working pose + nozzle pixel/touch height; used automatically; answering 'm' after a miss refines it online)
2026-10-16 Serialise every lgpio tx_*/gpio_read call behind one lock (status polling raced the move thread and could wedge all queues); restart on a second wedge within 3 min
2026-10-16 Docs: PICKING.md (pick cycle, calibration, settings, recovery), endpoints in USAGE, architecture notes, links
2026-10-16 Fix the real cause of 'TX queues stuck': lgpio's tx thread wedges when a finished HEAD record is deleted with another axis running behind it; keep a silent anchor record at the head (GPIO21), model t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
2026-10-16 Camera mount: parametric 3D model (cad/camera_mount.py, STL), D435 bracket for the front of the arm with nozzle holder, doc and previews
2026-10-16 Camera mount: nozzle holder as a separate part so the mount prints without supports; screw recess sized for a 1/4-20 x 3/8" screw; BOM and print notes
2026-10-16 Camera mount doc: shopping list of screws and nuts, PLA-first printing advice, screw length check
2026-10-20 Add reference photos of the arm and the camera
2026-10-20 Preview: one shared detection worker for every viewer of /camera?detect=1 (idle when nobody watches) instead of one detector per browser
2026-10-20 Dashboard: 3D view of the arm (canvas 2D, no WebGL) toggled on the camera panel; drag to orbit, coins on the table, camera polling paused while shown
2026-10-20 3D view: detailed plate model (column, motor, upper arm, forearm with levelling rod, camera, nozzle holder) with flat shading; follow the arm through the cheap GET /pose instead of the full /status; 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
2026-10-20 Vision: label yellow (no-depth) coins with the raw depth read, 'hole' when the sensor gave nothing; depth_raw in /detect
2026-10-20 3D view: full-screen panel while open (with a STOP button that triggers the emergency disable)
2026-10-26 Retune pickup nozzle dimensions and update docs
    - Adjust PROTRUDE (10.0 -> 9.0) and TOP_REST (-10.0 -> -12.0)
    - Update PUMP.md numbers to match: nozzle mass split, housing/tube
    length, collar clamp position, spring preload
    - Add generated STLs for the collar, housing, and nozzle assembly
